advay03/EME-185---Organ-on-a-chip/Components/Low cost peristaltic pump - 254956/images/tube-support.jpg

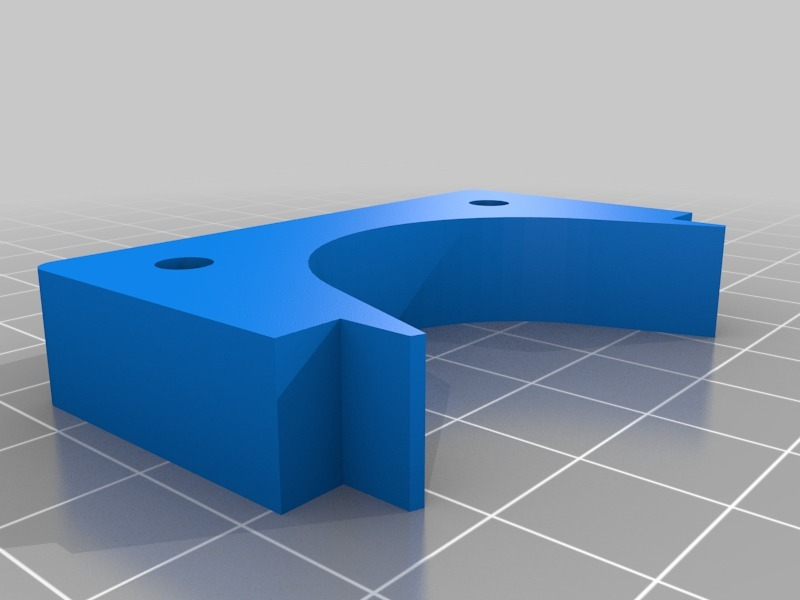
Components/Low cost peristaltic pump - 254956/images/tube-support.jpg
