advay03/EME-185---Organ-on-a-chip/Receipts/Arduino Uno Rev3 Invoice.pdf

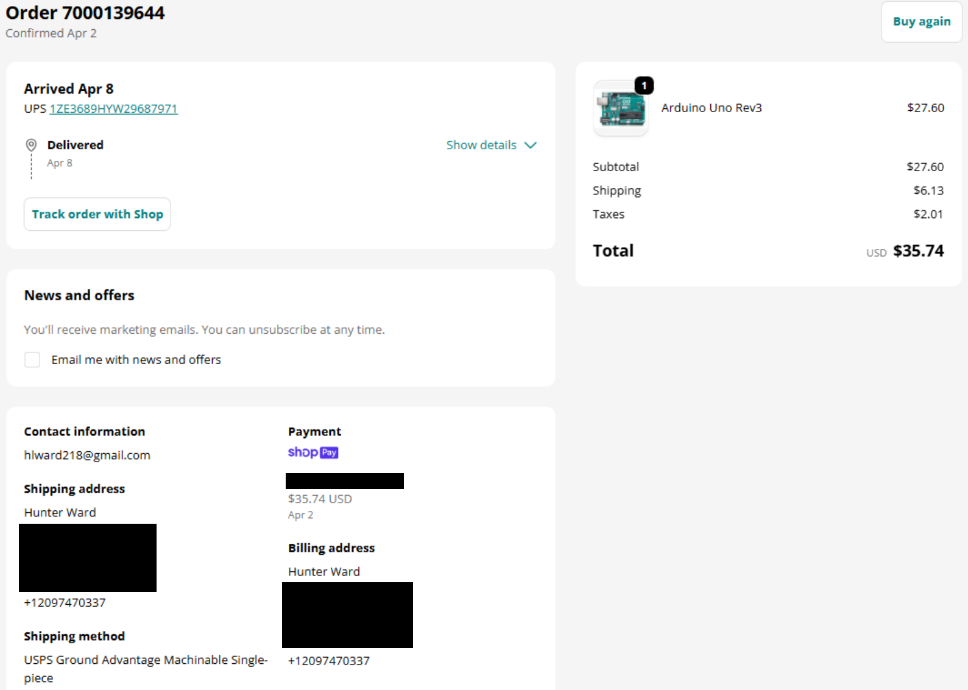
[picture p3: page 1]
