advay03/EME-185---Organ-on-a-chip/Components/Low cost peristaltic pump - 254956/images/bearing-hub-top.jpg

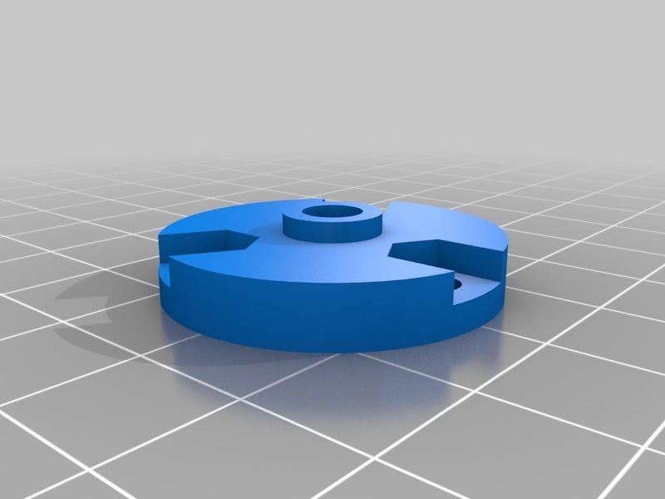
Components/Low cost peristaltic pump - 254956/images/bearing-hub-top.jpg
