advay03/EME-185---Organ-on-a-chip/Components/Low cost peristaltic pump - 254956/images/CheapPump3-1mm-pump-top.png

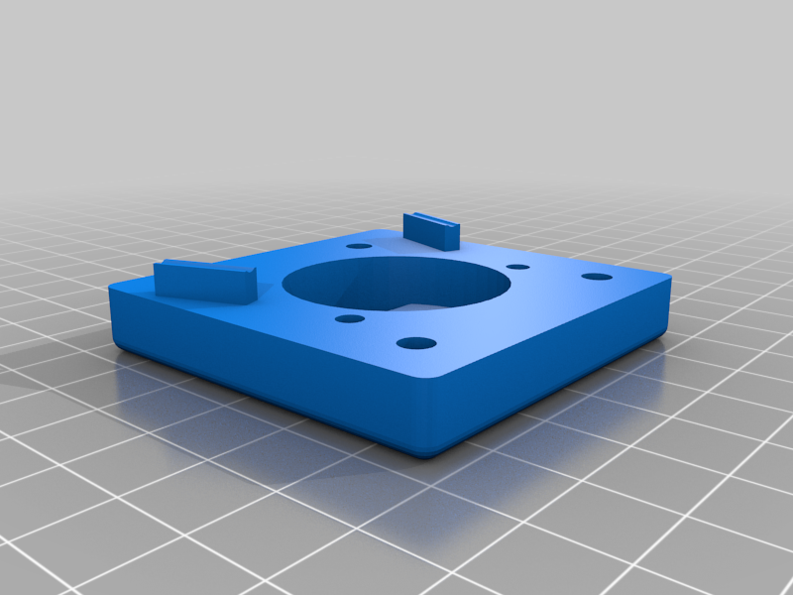
Components/Low cost peristaltic pump - 254956/images/CheapPump3-1mm-pump-top.png
