advay03/EME-185---Organ-on-a-chip/Components/Low cost peristaltic pump - 254956/images/DSCN1205.JPG

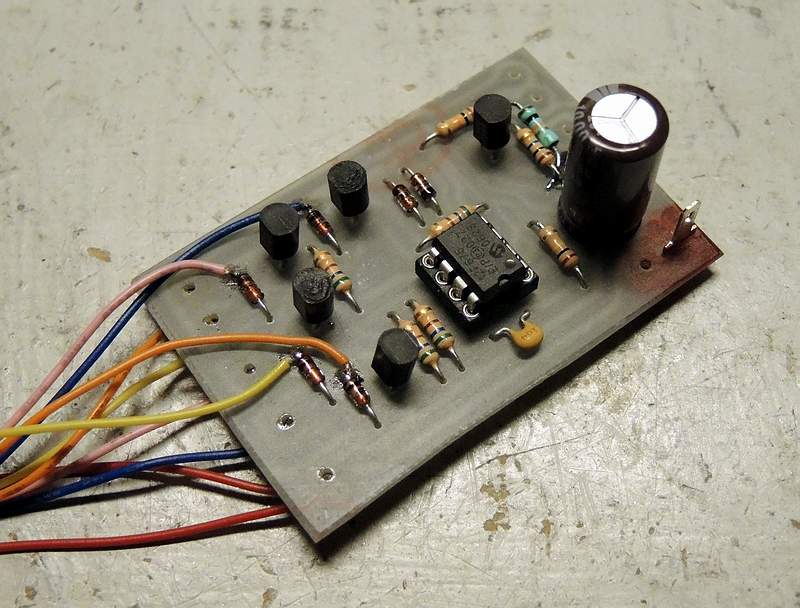
Components/Low cost peristaltic pump - 254956/images/DSCN1205.JPG
