advay03/EME-185---Organ-on-a-chip/Components/Low cost peristaltic pump - 254956/files/PumpaCheapo.SLDASM

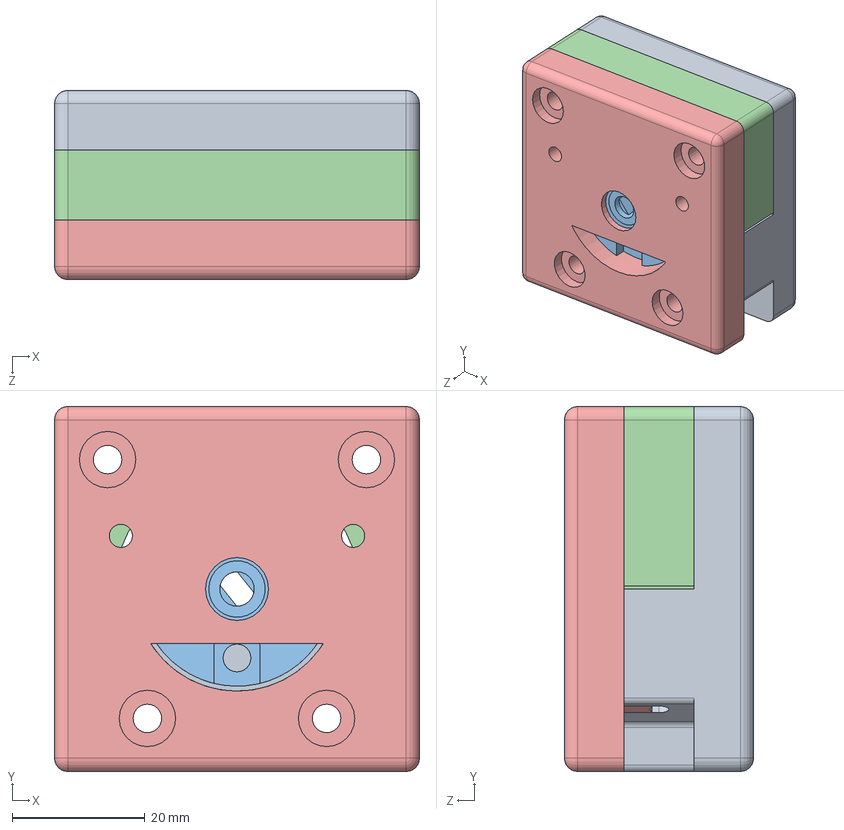
[picture p10: CAD file, 2026-04-03]
Components/Low cost peristaltic pump - 254956/files/PumpaCheapo.SLDASM
55.0 x 55.0 x 28.5 mm
CheapPump
bearing-hub
bearing-hub-top
tube-support
pump-top
