advay03/EME-185---Organ-on-a-chip/Components/Low cost peristaltic pump - 254956/files/CheapPump.SLDPRT

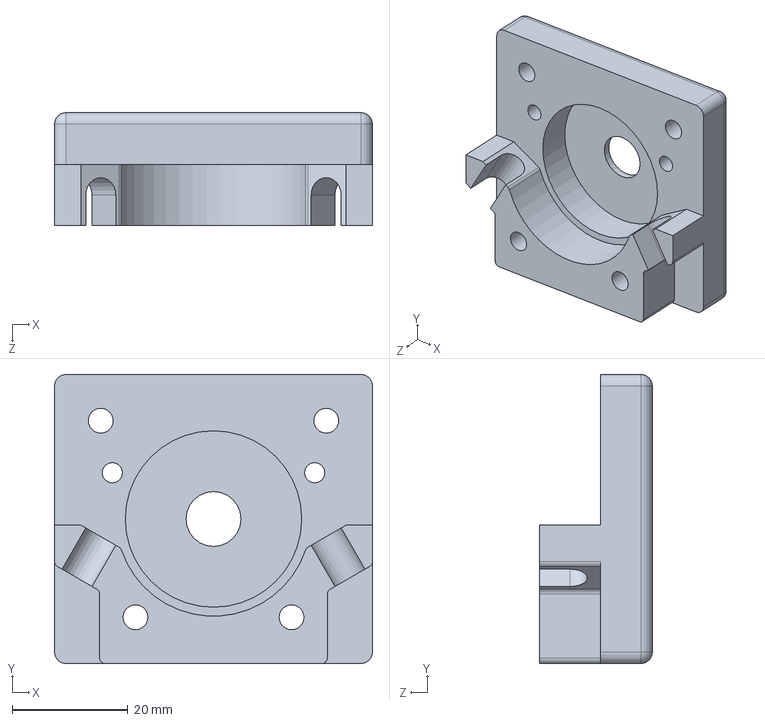
[picture p11: CAD file, 2026-04-03]
Components/Low cost peristaltic pump - 254956/files/CheapPump.SLDPRT
55.0 x 50.0 x 19.5 mm
