advay03/EME-185---Organ-on-a-chip/Electronics/Perf Board.SLDPRT

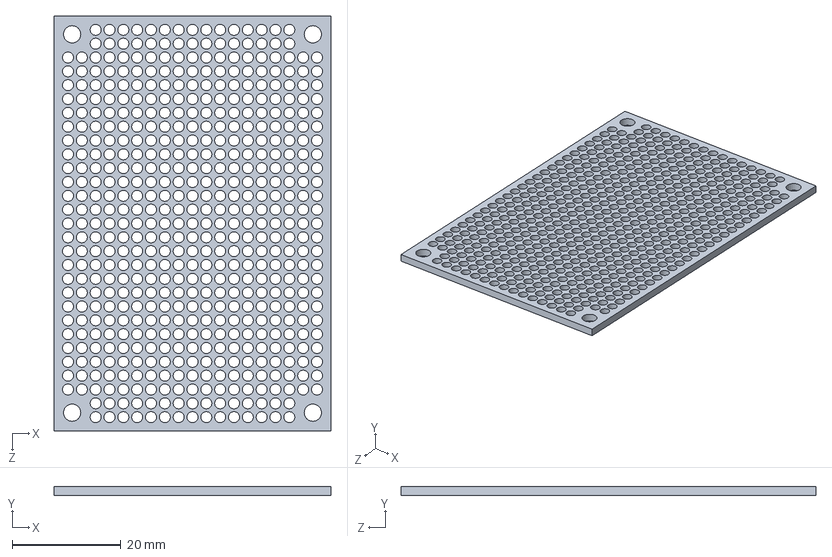
[picture p12: CAD file, 2026-05-25]
Electronics/Perf Board.SLDPRT
50.8 x 1.59 x 76.2 mm
