advay03/EME-185---Organ-on-a-chip/Heater/Heater.SLDPRT

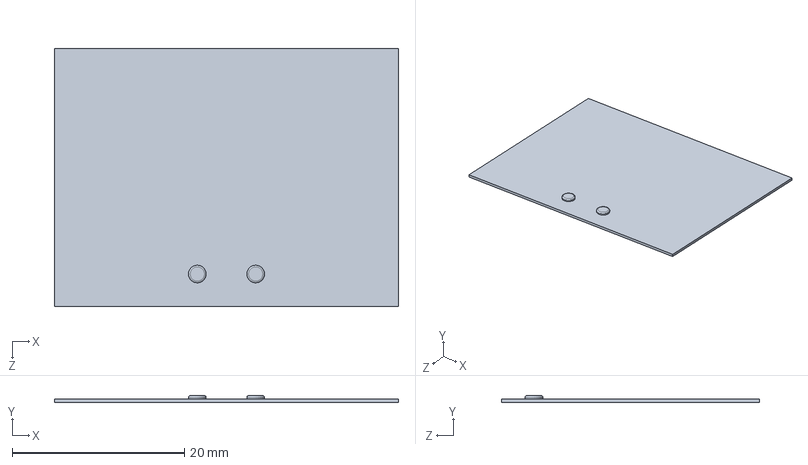
[picture p13: CAD file, 2026-04-03]
Heater/Heater.SLDPRT
40.0 x 0.8 x 30.0 mm
