advay03/EME-185---Organ-on-a-chip/HMI/HMI.stp

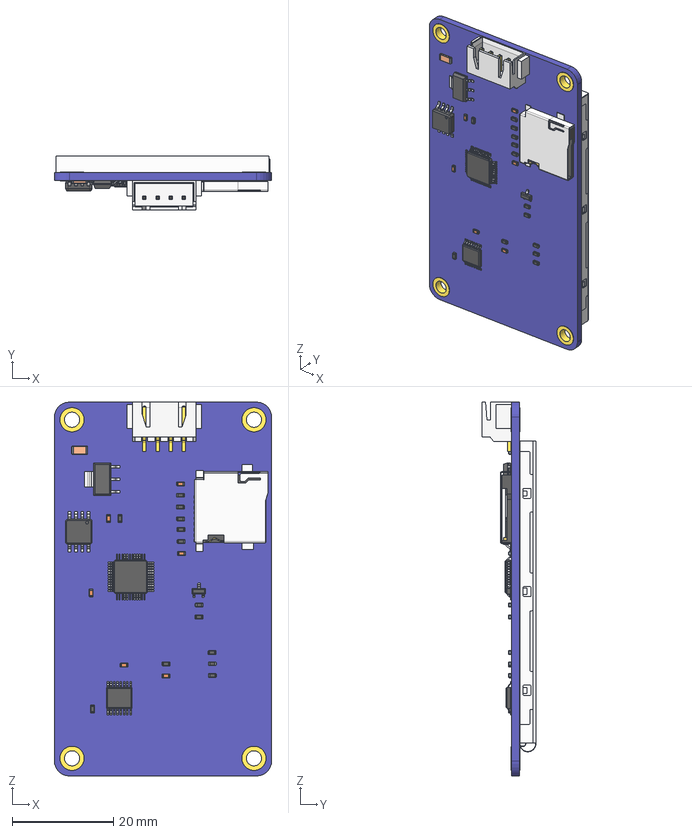
[picture p14: CAD file, 2026-04-03]
HMI/HMI.stp
43.0 x 10.7 x 74.0 mm
NX3224T024_011_PCB
AMS1117
603_Cap x 6
1206_Cap
603_Resistor x 13
IcNextion
24_pin_IC
16_pin_IC
SMD_Trans
Micro_SD_Slot
SD_Center
Nextion_Plug
LCD
