advay03/EME-185---Organ-on-a-chip/Packaging/Rev 3/Tray_Rev3.SLDPRT

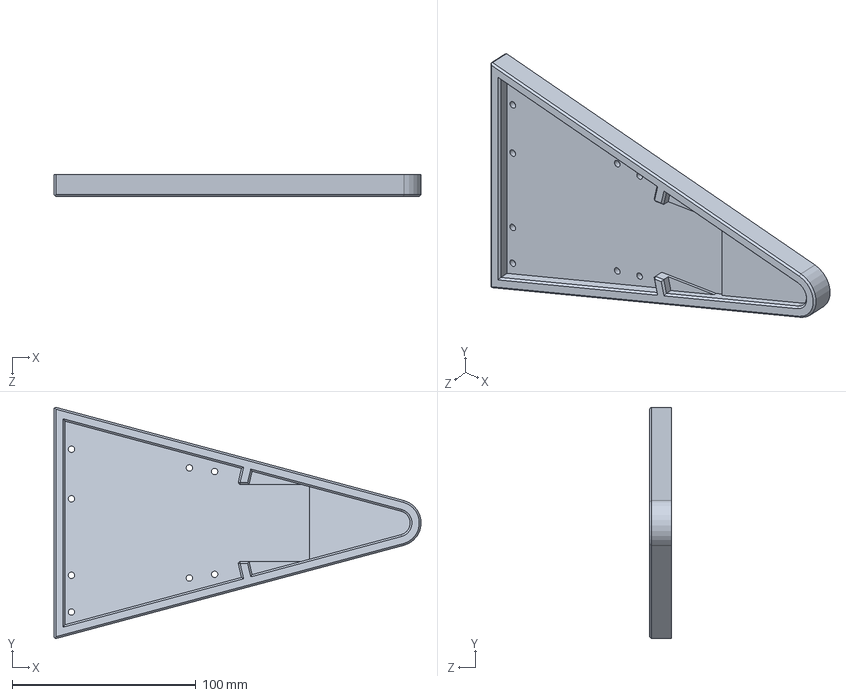
[picture p15: CAD file, 2026-06-06]
Packaging/Rev 3/Tray_Rev3.SLDPRT
199.9 x 126.1 x 12.0 mm
