advay03/EME-185---Organ-on-a-chip/Peristaltic Pump/Custom Design/3D Print Files/Bearing Jig.SLDPRT

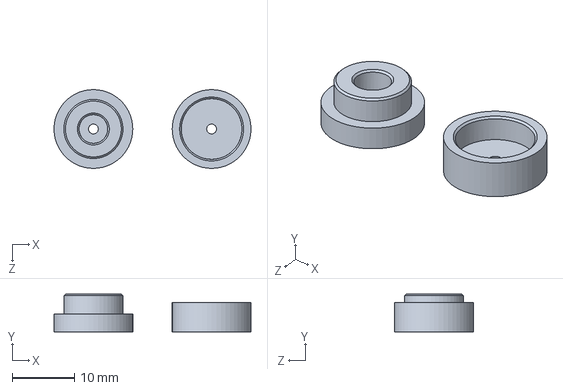
[picture p16: CAD file, 2026-06-06]
Peristaltic Pump/Custom Design/3D Print Files/Bearing Jig.SLDPRT
31.8 x 6.10 x 12.7 mm
