advay03/EME-185---Organ-on-a-chip/Peristaltic Pump/Custom Design/Indivisual Parts/Pump_Rotor_Housing.SLDPRT

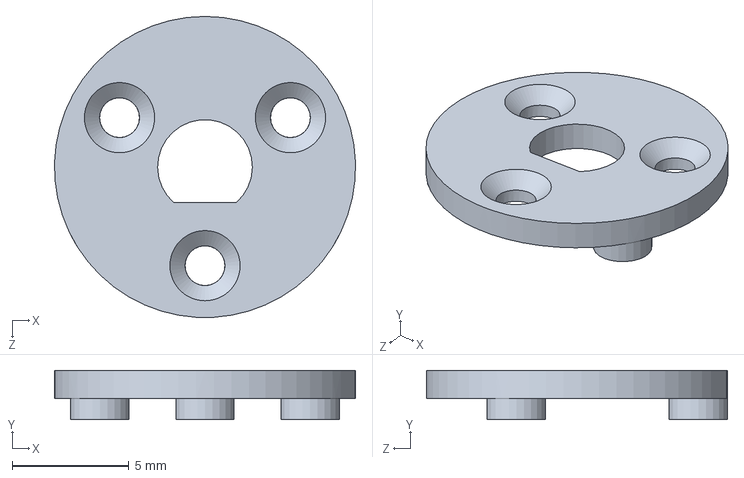
[picture p17: CAD file, 2026-06-06]
Peristaltic Pump/Custom Design/Indivisual Parts/Pump_Rotor_Housing.SLDPRT
12.9 x 2.10 x 12.9 mm
