advay03/EME-185---Organ-on-a-chip/Electronics/6121 TMC2209 Driver.step

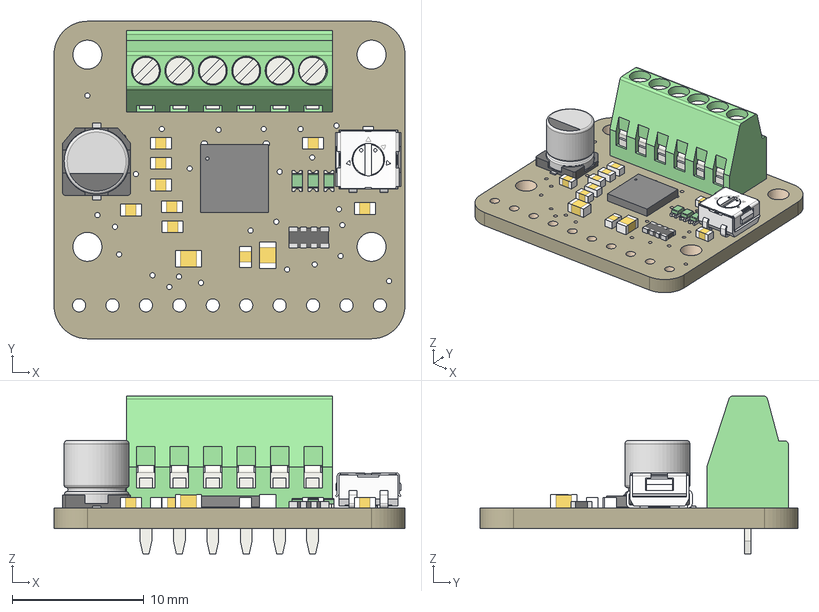
[picture p18: CAD file, 2026-04-03]
Electronics/6121 TMC2209 Driver.step
26.7 x 24.1 x 12.0 mm
Board
0.22uF/50V x 9
10K
10uF x 2
6-pin 2.54 Terminal
22uF/50V
GREEN x 3
20K Pack
TMC2209_QFN
