advay03/EME-185---Organ-on-a-chip/Heater/NTCLE213E3103FLB0A.stp

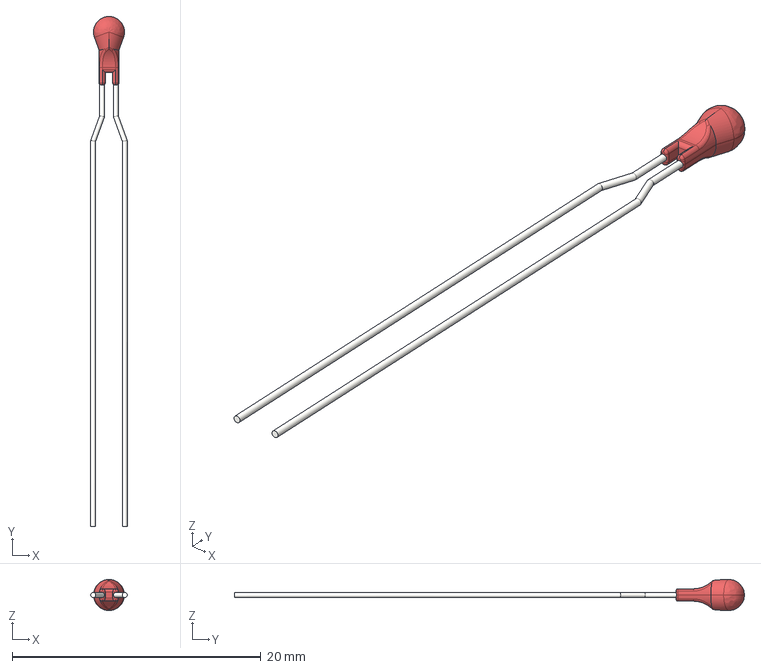
[picture p19: CAD file, 2026-04-03]
Heater/NTCLE213E3103FLB0A.stp
2.94 x 41.0 x 2.50 mm
