advay03/EME-185---Organ-on-a-chip/Packaging/Rev 3/Peristaltic Pump Holder_Rev-3.SLDPRT

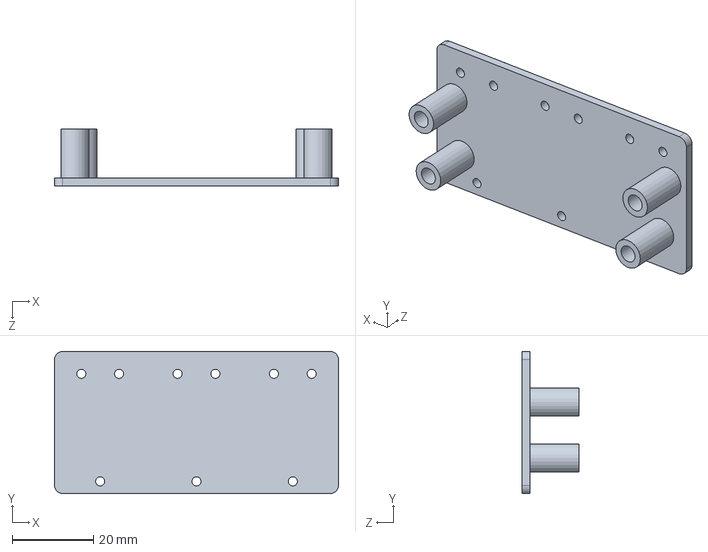
[picture p20: CAD file, 2026-05-25]
Packaging/Rev 3/Peristaltic Pump Holder_Rev-3.SLDPRT
70.0 x 35.0 x 14.0 mm
