advay03/EME-185---Organ-on-a-chip/Peristaltic Pump/Custom Design/3D Print Files/Bearing Jig Lower.SLDPRT

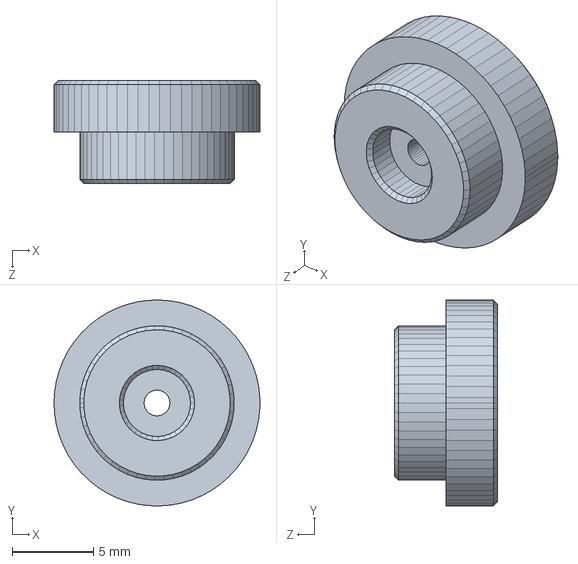
[picture p21: CAD file, 2026-06-06]
Peristaltic Pump/Custom Design/3D Print Files/Bearing Jig Lower.SLDPRT
12.7 x 12.7 x 6.35 mm
