advay03/EME-185---Organ-on-a-chip/Peristaltic Pump/Custom Design/Indivisual Parts/Pump_Housing_Cover.SLDPRT

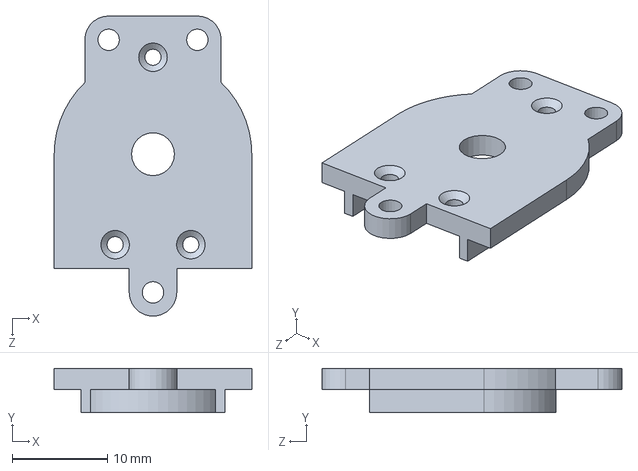
[picture p22: CAD file, 2026-06-06]
Peristaltic Pump/Custom Design/Indivisual Parts/Pump_Housing_Cover.SLDPRT
20.7 x 4.65 x 31.5 mm
