advay03/EME-185---Organ-on-a-chip/Components/Low cost peristaltic pump - 254956/files/CheapPump3-1mm-CheapPump.STL

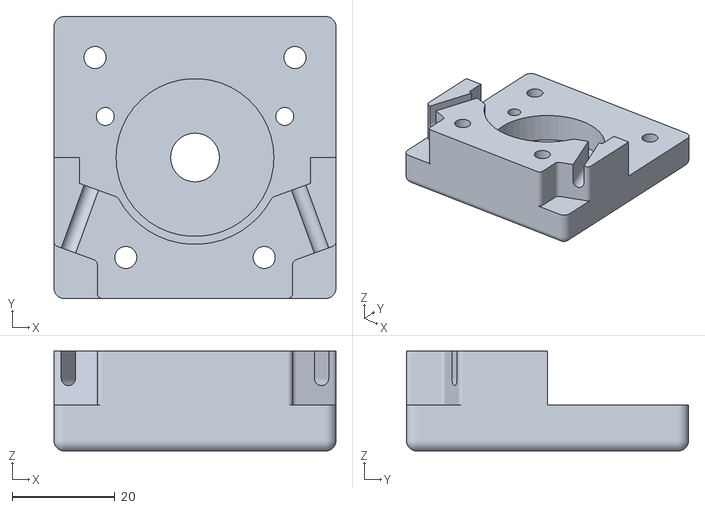
[picture p23: CAD file, 2026-04-03]
Components/Low cost peristaltic pump - 254956/files/CheapPump3-1mm-CheapPump.STL
55.0 x 55.0 x 19.5
