advay03/EME-185---Organ-on-a-chip/Packaging/Rev 3/Perf Board Holder.STL

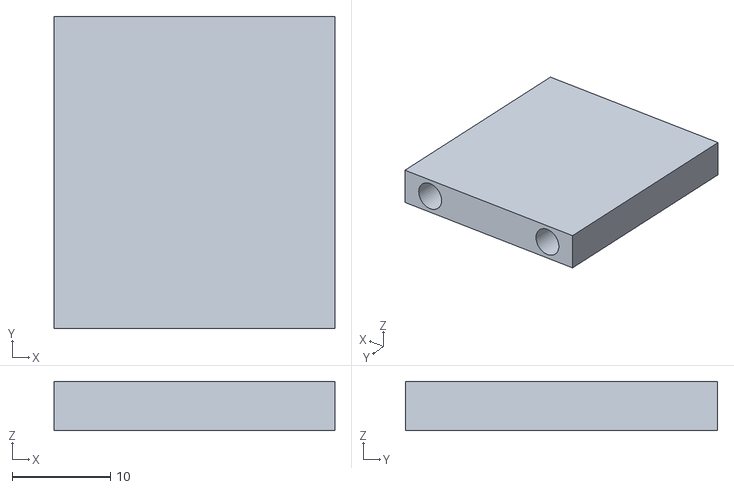
[picture p24: CAD file, 2026-04-20]
Packaging/Rev 3/Perf Board Holder.STL
28.6 x 31.8 x 5.00
