advay03/EME-185---Organ-on-a-chip/Peristaltic Pump/Custom Design/3D Print Files/Bearing Jig Upper.STL

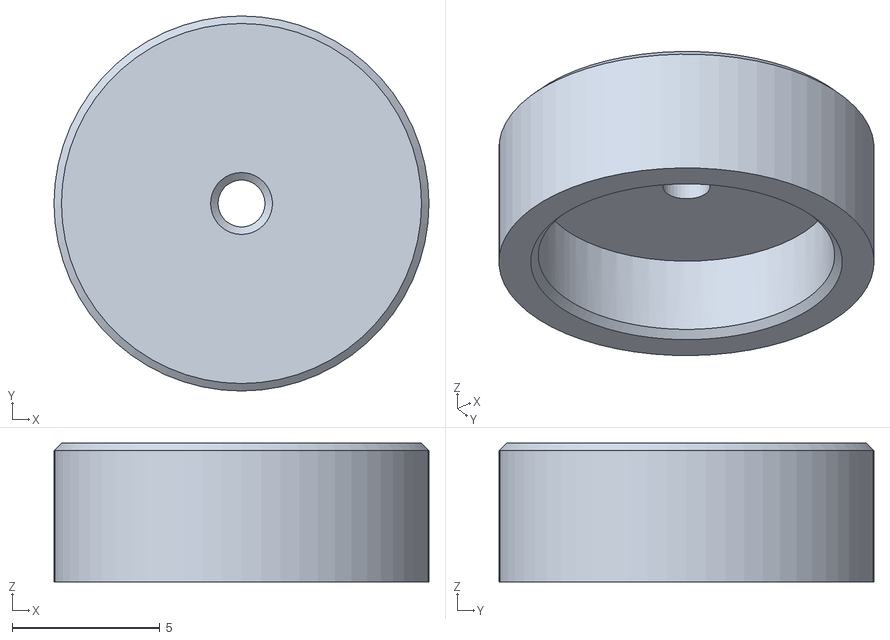
[picture p25: CAD file, 2026-05-29]
Peristaltic Pump/Custom Design/3D Print Files/Bearing Jig Upper.STL
12.7 x 12.7 x 4.70
