advay03/EME-185---Organ-on-a-chip/Peristaltic Pump/Custom Design/Custom_design_v3.SLDPRT

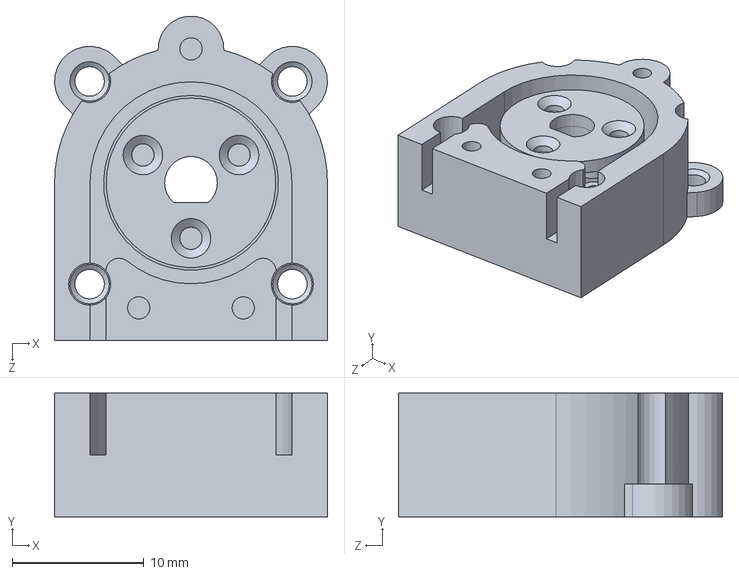
[picture p26: CAD file, 2026-05-12]
Peristaltic Pump/Custom Design/Custom_design_v3.SLDPRT
20.7 x 9.40 x 24.7 mm
