advay03/EME-185---Organ-on-a-chip/Peristaltic Pump/Custom Design/Indivisual Parts/Pump_Housing.SLDPRT

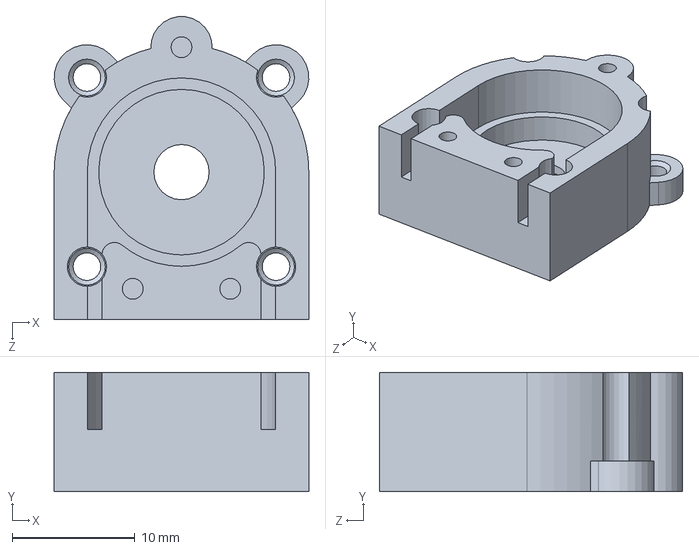
[picture p27: CAD file, 2026-06-06]
Peristaltic Pump/Custom Design/Indivisual Parts/Pump_Housing.SLDPRT
20.7 x 9.70 x 24.7 mm
