advay03/EME-185---Organ-on-a-chip/Peristaltic Pump/PeristalticPump-185.SLDPRT

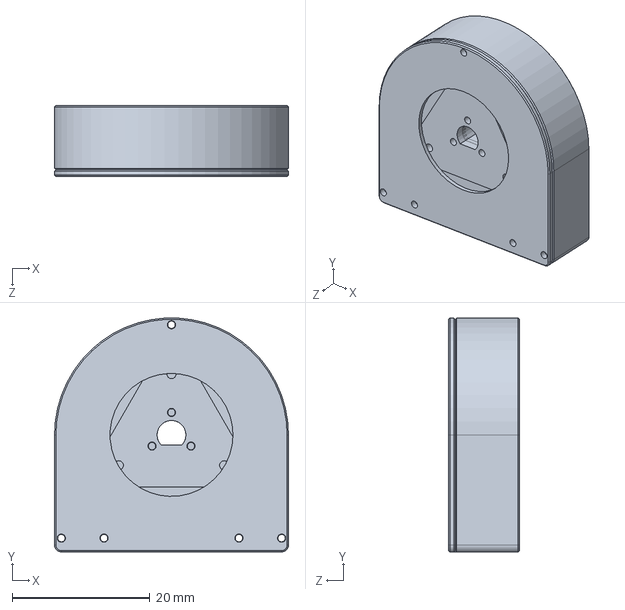
[picture p28: CAD file, 2026-04-03]
Peristaltic Pump/PeristalticPump-185.SLDPRT
34.0 x 34.0 x 10.3 mm
