advay03/EME-185---Organ-on-a-chip/Pod for team 14.stl

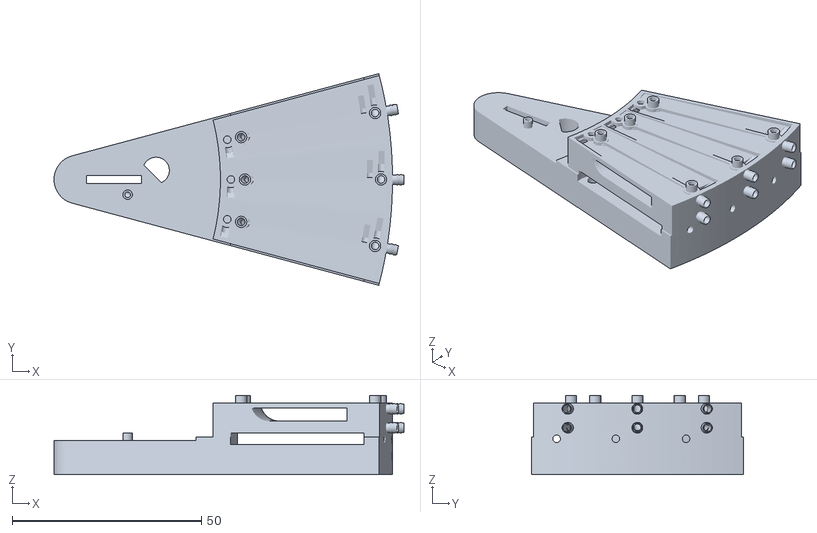
[picture p29: CAD file, 2026-04-03]
Pod for team 14.stl
92.5 x 56.0 x 21.0
