advay03/EME-185---Organ-on-a-chip/Components/Low cost peristaltic pump - 254956/files/pump-top.SLDPRT

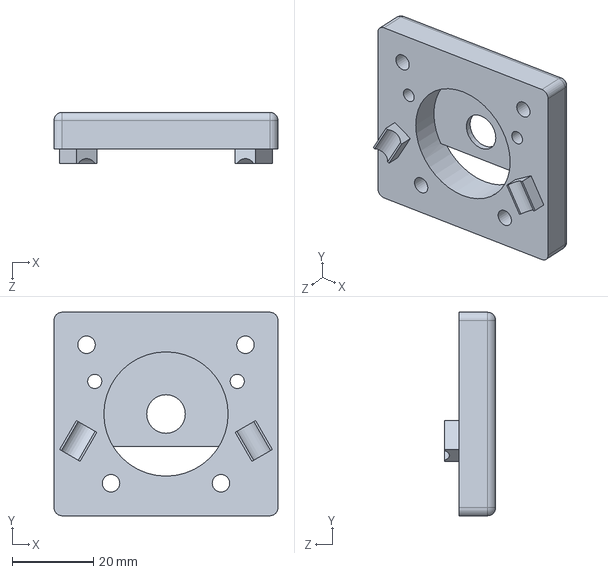
[picture p30: CAD file, 2026-04-03]
Components/Low cost peristaltic pump - 254956/files/pump-top.SLDPRT
55.0 x 50.0 x 12.6 mm
