advay03/EME-185---Organ-on-a-chip/Packaging/Rev 3/Arduino Holder.STL

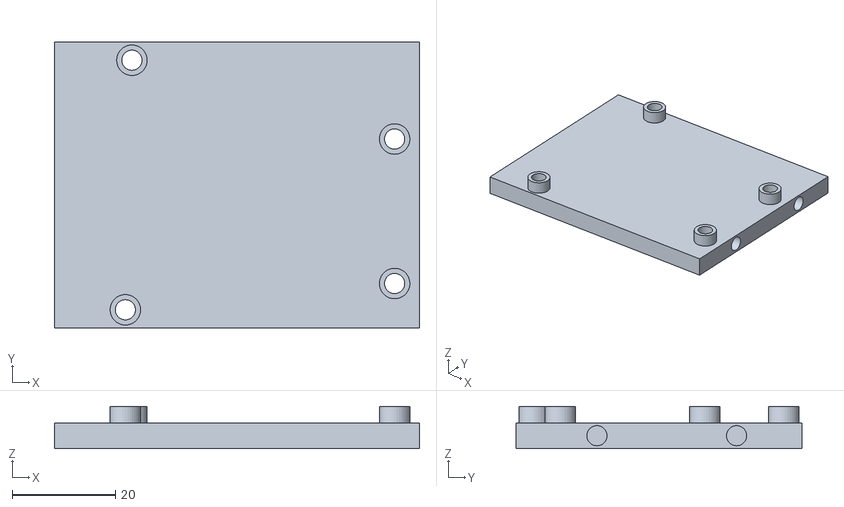
[picture p31: CAD file, 2026-04-20]
Packaging/Rev 3/Arduino Holder.STL
70.6 x 55.3 x 8.18
