advay03/EME-185---Organ-on-a-chip/Peristaltic Pump/Custom Design/3D Print Files/Custom_Rotor.STL

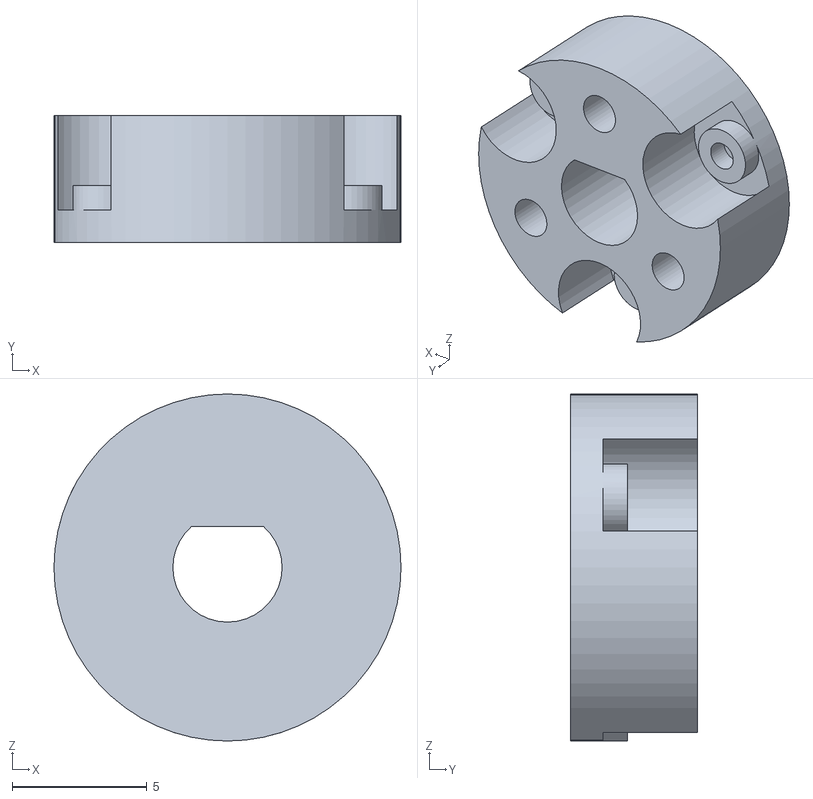
[picture p32: CAD file, 2026-05-25]
Peristaltic Pump/Custom Design/3D Print Files/Custom_Rotor.STL
12.9 x 4.70 x 12.9
