advay03/EME-185---Organ-on-a-chip/Peristaltic Pump/Nema 8 Step motor.STEP

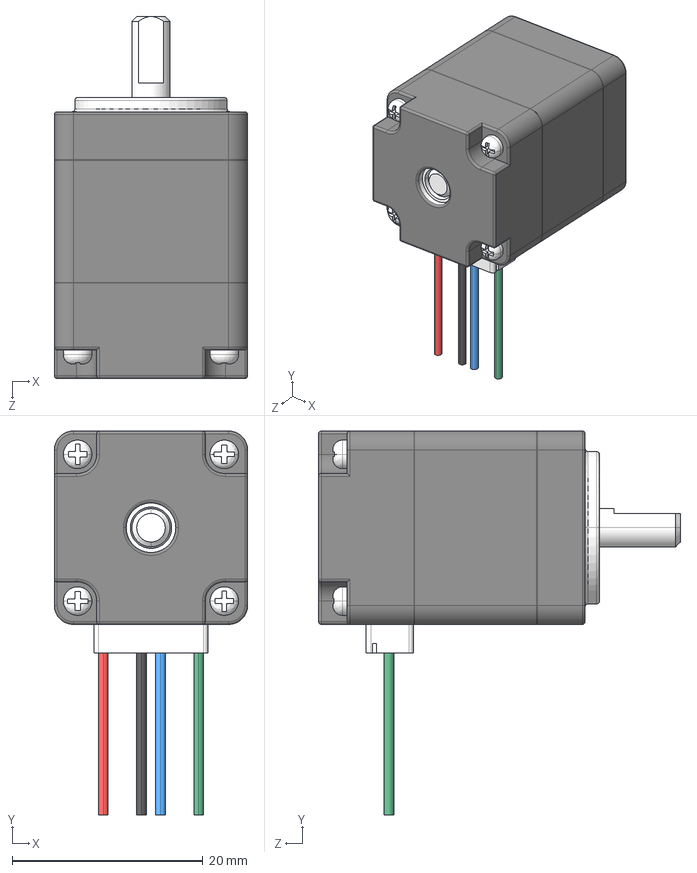
[picture p33: CAD file, 2026-04-03]
Peristaltic Pump/Nema 8 Step motor.STEP
20.3 x 40.3 x 38.0 mm
