advay03/EME-185---Organ-on-a-chip/Components/Low cost peristaltic pump - 254956/files/tube-support.SLDPRT

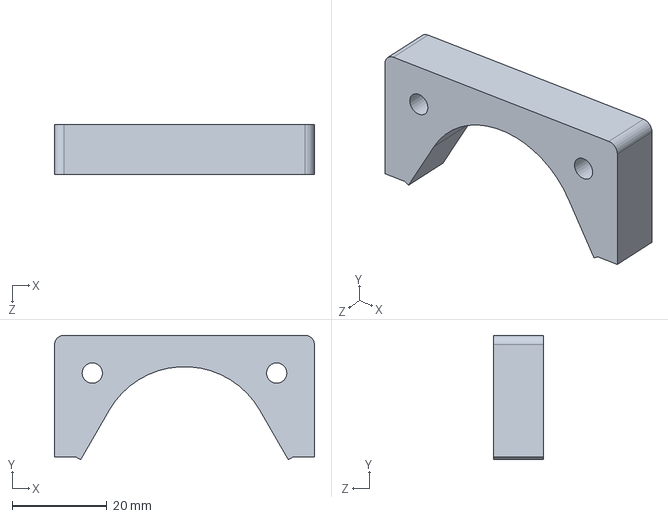
[picture p34: CAD file, 2026-04-03]
Components/Low cost peristaltic pump - 254956/files/tube-support.SLDPRT
55.0 x 26.3 x 10.5 mm
