advay03/EME-185---Organ-on-a-chip/Electronics/Heater control circuit_ Mosfet - FQP30N06.stp

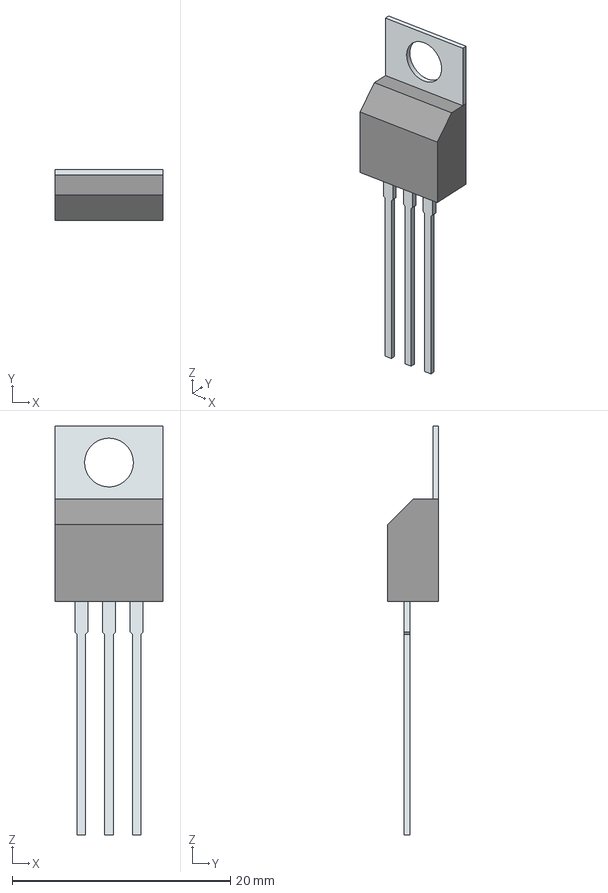
[picture p35: CAD file, 2026-04-03]
Electronics/Heater control circuit_ Mosfet - FQP30N06.stp
9.90 x 4.70 x 37.5 mm
Tab
PinsArray
