advay03/EME-185---Organ-on-a-chip/Components/Low cost peristaltic pump - 254956/files/bearing-hub.SLDPRT

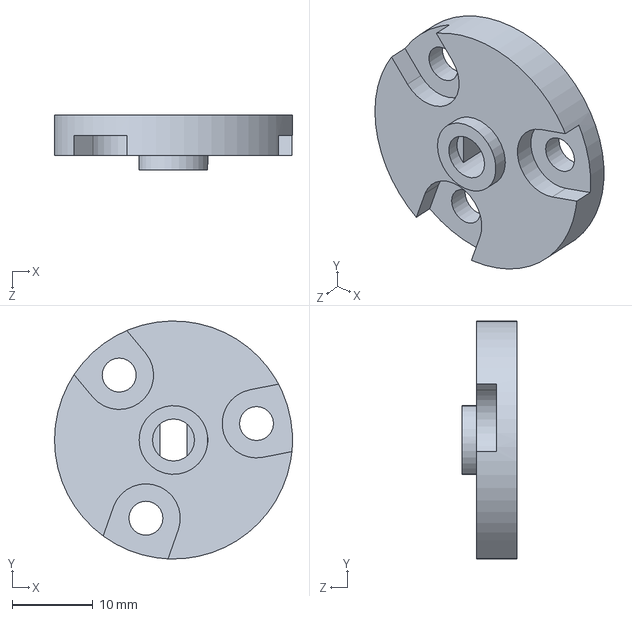
[picture p36: CAD file, 2026-04-03]
Components/Low cost peristaltic pump - 254956/files/bearing-hub.SLDPRT
29.4 x 29.4 x 6.75 mm
