advay03/EME-185---Organ-on-a-chip/Electronics/arduino uno.SLDPRT

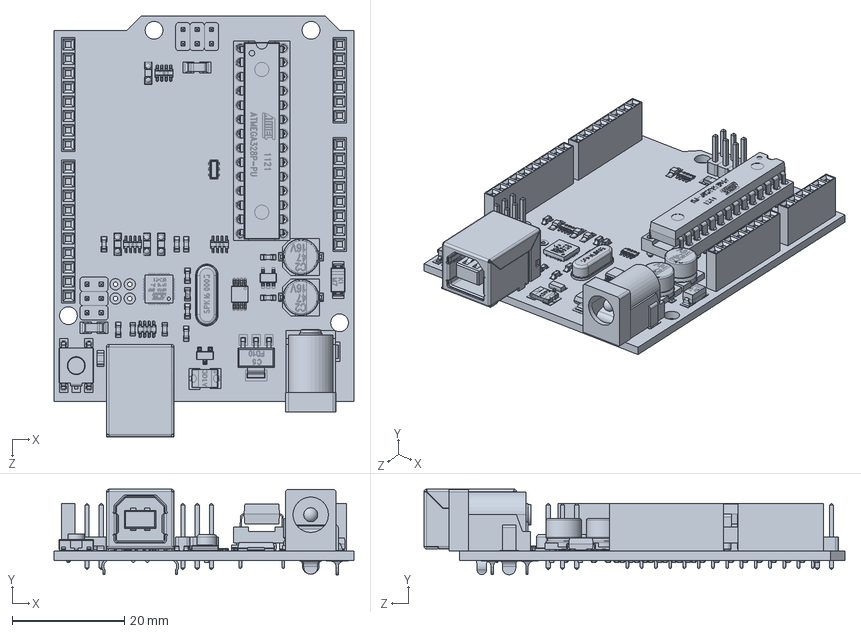
[picture p37: CAD file, 2026-04-03]
Electronics/arduino uno.SLDPRT
53.3 x 15.2 x 74.9 mm
