advay03/EME-185---Organ-on-a-chip/Peristaltic Pump/Custom Design/3D Print Files/Pump_Print_Plate.3mf

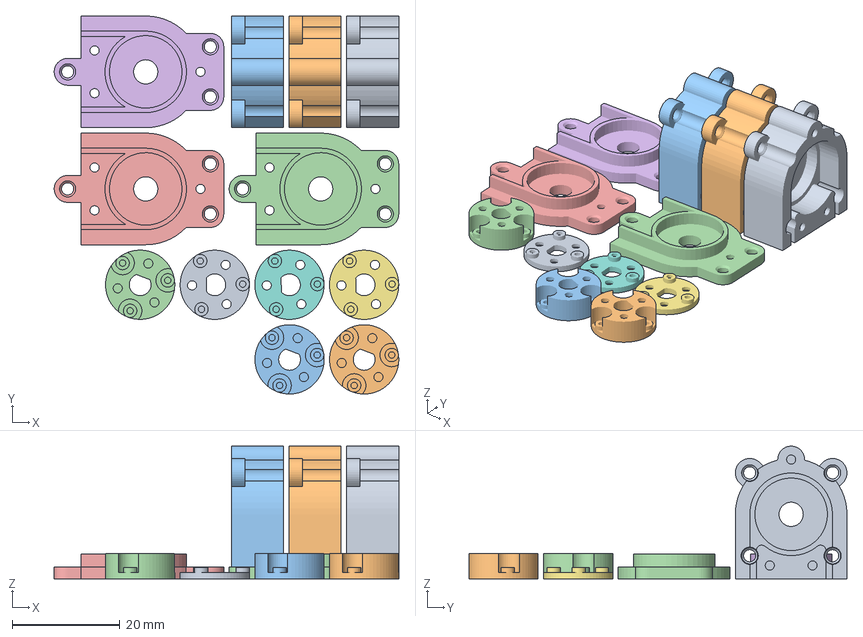
[picture p39: CAD file, 2026-05-25]
Peristaltic Pump/Custom Design/3D Print Files/Pump_Print_Plate.3mf
64.0 x 70.2 x 24.7 mm
Custom_Housing.STL x 3
Custom_Housing_Cap.STL x 3
Custom_Rotor_Cap.STL x 3
Custom_Rotor.STL x 3
