advay03/EME-185---Organ-on-a-chip/Peristaltic Pump/Custom Design/Dowel Pins.SLDPRT

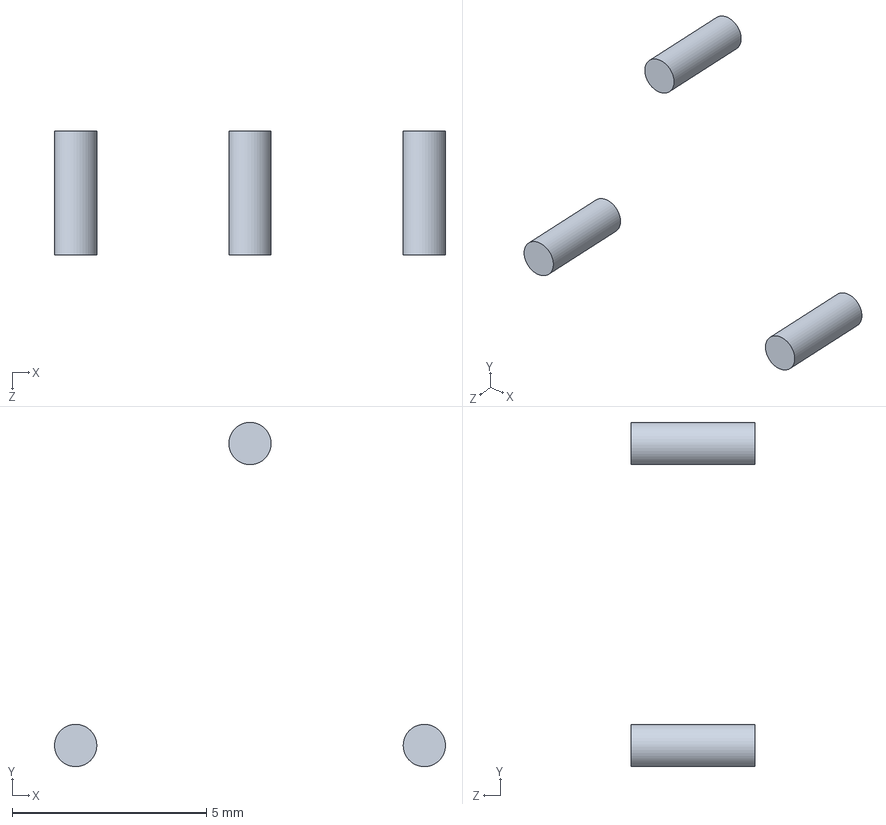
[picture p40: CAD file, 2026-04-14]
Peristaltic Pump/Custom Design/Dowel Pins.SLDPRT
10.1 x 8.87 x 3.20 mm
