advay03/EME-185---Organ-on-a-chip/Components/Low cost peristaltic pump - 254956/files/CheapPump3-1mm-pump-top.STL

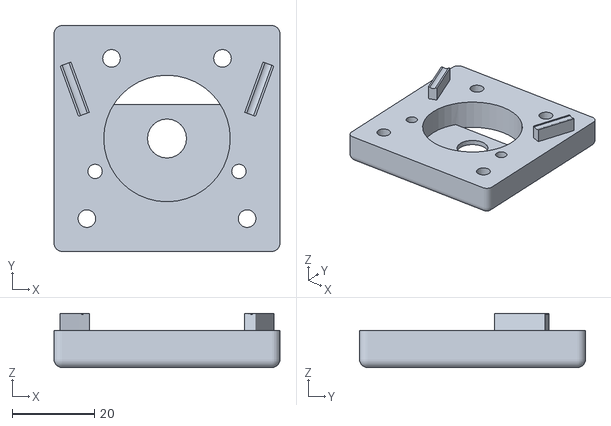
[picture p41: CAD file, 2026-04-03]
Components/Low cost peristaltic pump - 254956/files/CheapPump3-1mm-pump-top.STL
55.0 x 55.0 x 13.2
