advay03/EME-185---Organ-on-a-chip/Peristaltic Pump/Custom Design/Custom design.SLDPRT

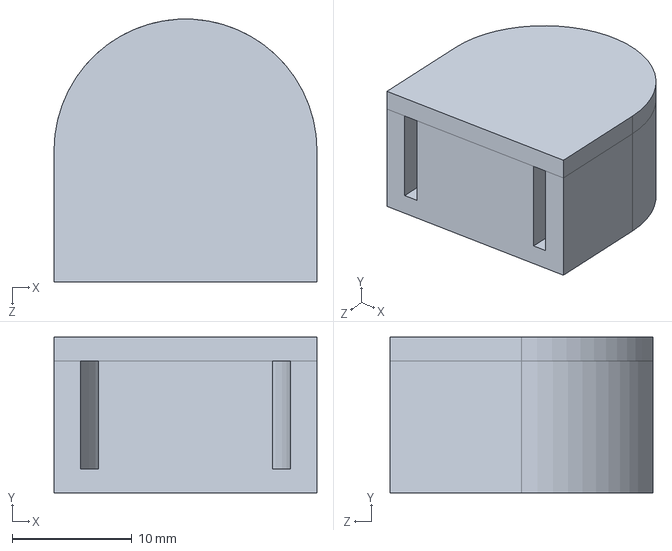
[picture p42: CAD file, 2026-04-08]
Peristaltic Pump/Custom Design/Custom design.SLDPRT
21.9 x 13.0 x 21.9 mm
