advay03/EME-185---Organ-on-a-chip/Components/Low cost peristaltic pump - 254956/files/pump-base.stl

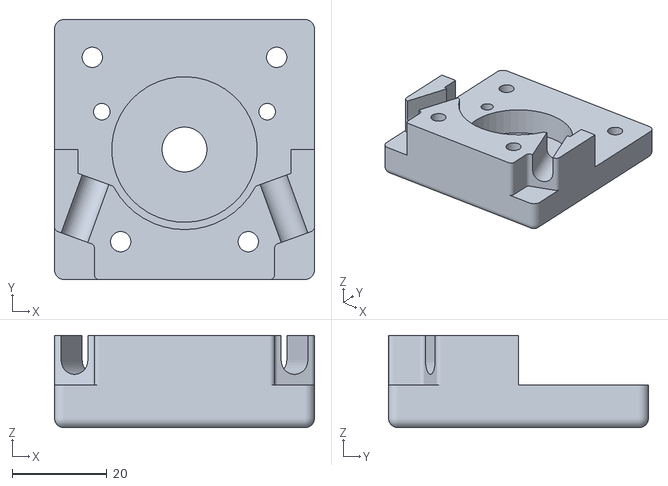
[picture p43: CAD file, 2026-04-03]
Components/Low cost peristaltic pump - 254956/files/pump-base.stl
55.0 x 55.0 x 19.5
