advay03/EME-185---Organ-on-a-chip/Peristaltic Pump/Pump Subassembly.SLDASM

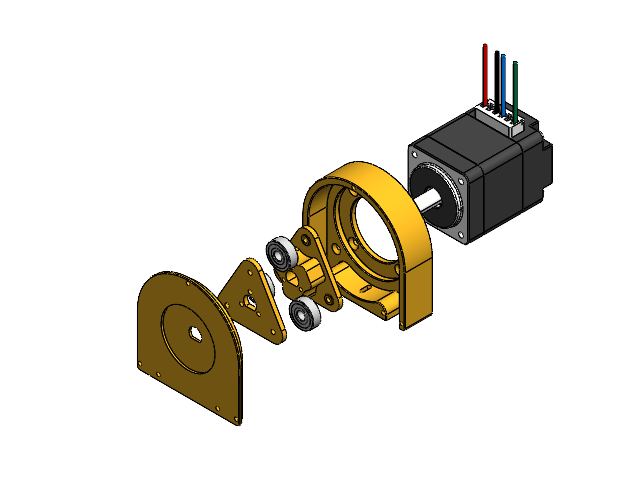
[picture p44: CAD file, 2026-04-04]
Peristaltic Pump/Pump Subassembly.SLDASM
PeristalticPump-185
Nema 8 Step motor.step
7487N44_High-Precision Corrosion-Resistant 440C Stainless Steel Ball Bearing x 3
