advay03/EME-185---Organ-on-a-chip/System Assembly - Rev 3.SLDASM

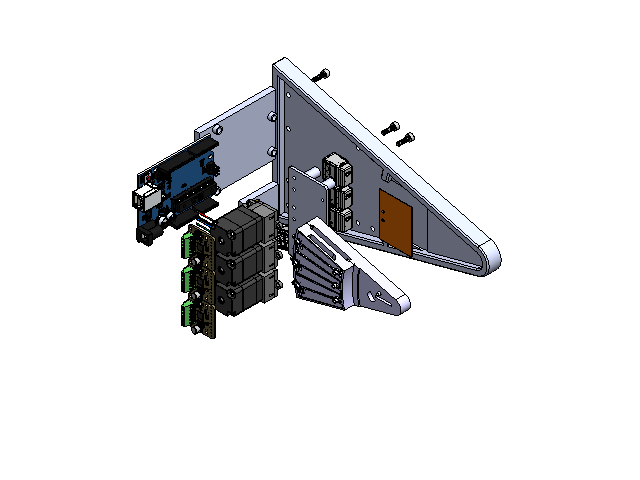
[picture p45: CAD file, 2026-06-06]
System Assembly - Rev 3.SLDASM
Tray_Rev3
Pod for team 14
Arduino Holder
Perf Board Holder
Peristaltic Pump Holder_Rev-3
Custom_design_v2 x 3
57155K341_Stainless Steel Ball Bearing x 9
Dowel Pins x 3
91305A103_JIS Zinc-Plated Steel Flat Head Screws x 30
Nema 8 Step motor.step x 3
arduino uno
Perf Board
9915K36_Quick-Connect Push-on Wire Connectors x 3
9915K37_Quick-Connect Push-on Wire Connectors
Board_2.step x 3
0.22uF_50V_2.step x 27
10K_2.step x 3
10uF_2.step x 6
6-pin 2.54 Terminal_2.step x 3
22uF_50V_2.step x 3
GREEN_2.step x 9
20K Pack_2.step x 3
TMC2209_QFN_2.step x 3
91292A113_18-8 Stainless Steel Socket Head Screw x 8
Heater
