advay03/EME-185---Organ-on-a-chip/Peristaltic Pump/Custom Design/Custom Pump Assembly.SLDASM

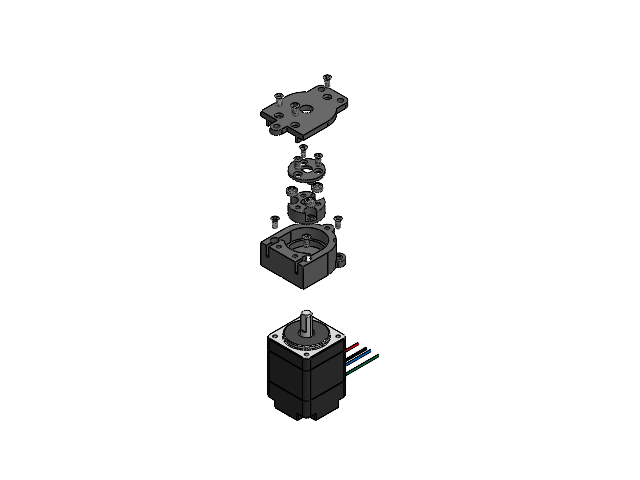
[picture p46: CAD file, 2026-06-06]
Peristaltic Pump/Custom Design/Custom Pump Assembly.SLDASM
Custom_design_v2
57155K341_Stainless Steel Ball Bearing x 3
Dowel Pins
91305A103_JIS Zinc-Plated Steel Flat Head Screws x 10
Nema 8 Step motor.step
