advay03/EME-185---Organ-on-a-chip/(list of files, cad)

Other CAD files:
Peristaltic Pump/Custom Design/Indivisual Parts/Pump_Rotor.SLDPRT
Peristaltic Pump/Custom Design/3D Print Files/Custom_Rotor_Cap.STL
Peristaltic Pump/Custom Design/3D Print Files/Custom_Housing.STL
Peristaltic Pump/Custom Design/3D Print Files/Custom_Housing_Cap.STL
Components/Low cost peristaltic pump - 254956/files/bearing-hub-top.stl
Components/Low cost peristaltic pump - 254956/files/bearing-hub.stl
Components/Low cost peristaltic pump - 254956/files/pump-top.stl
Components/Low cost peristaltic pump - 254956/files/tube-support.stl
Drawings/Rev 2/Circuit Assembly Lid.SLDDRW
Drawings/Rev 2/Electronics System.SLDDRW
Drawings/Rev 2/HMI.SLDDRW
Drawings/Rev 2/Packaging Assembly.SLDDRW
Drawings/Rev 2/PeristalticPump Cover.SLDDRW
Drawings/Rev 2/PeristalticPump Housing.SLDDRW
Drawings/Rev 2/PeristalticPump Rotor Cover.SLDDRW
Drawings/Rev 2/PeristalticPump Rotor.SLDDRW
Drawings/Rev 2/PeristalticPump-185.SLDDRW
Drawings/Rev 2/Pod Base.SLDDRW
Drawings/Rev 2/Pod for team 14.SLDDRW
Drawings/Rev 2/Pump Assembly Lid.SLDDRW
Drawings/Rev 2/Pump Subassembly.SLDDRW
Drawings/Rev 2/TRAY ASSEMBLY.SLDDRW
Drawings/Rev 2/Thermal System.SLDDRW
Drawings/Rev 3/Arduino Holder.SLDDRW
Drawings/Rev 3/Custom Pump Assembly.SLDDRW
Drawings/Rev 3/Custom Pump Assembly_Exploded Viiew.SLDDRW
Drawings/Rev 3/Perf Board Holder.SLDDRW
Drawings/Rev 3/Peristaltic Pump Holder_Rev-3.SLDDRW
Drawings/Rev 3/Pump_Housing.SLDDRW
Drawings/Rev 3/Pump_Housing_Cover.SLDDRW
Drawings/Rev 3/Pump_Rotor.SLDDRW
Drawings/Rev 3/Pump_Rotor_Housing.SLDDRW
Drawings/Rev 3/System Assembly - Exploded View.SLDDRW
Drawings/Rev 3/System Assembly - Rev 3.SLDDRW
Drawings/Rev 3/Tray_Rev3.SLDDRW
Electronics/6121 TMC2209 Driver.SLDASM
Electronics/8320N61_Barrel-Style DC Connector.SLDPRT
Electronics/9915K36_Quick-Connect Push-on Wire Connectors.SLDPRT
Electronics/9915K37_Quick-Connect Push-on Wire Connectors.SLDPRT
HMI/HMI.SLDASM
Hardware/91292A113_18-8 Stainless Steel Socket Head Screw.SLDPRT
Packaging/Drawings/Tray Dimensions Drawing.SLDDRW
Packaging/Rev 1/Circuit Assembly Lid.SLDPRT
Packaging/Rev 1/Hose Clamp.SLDPRT
Packaging/Rev 1/Packaging Assembly.SLDASM
Packaging/Rev 1/Pod Base.SLDPRT
Packaging/Rev 1/Pod for team 14.SLDPRT
Packaging/Rev 1/Power Adaptor CAD.SLDPRT
Packaging/Rev 1/Pump Assembly Lid.SLDPRT
Packaging/Rev 1/TRAY ASSEMBLY.SLDASM
Packaging/Rev 1/Tray Assembly - Pod, Pump, & Tray.SLDASM
Packaging/Rev 1/Velcro.SLDPRT
Packaging/Rev 2/Arduino Holder.SLDPRT
Packaging/Rev 2/MC Board Base.SLDPRT
Packaging/Rev 2/MC Board Spacer.SLDPRT
Packaging/Rev 2/Part1.SLDPRT
Packaging/Rev 2/Perf Board Holder.SLDPRT
Packaging/Rev 2/Pod Base_Rev2.SLDPRT
Packaging/Rev 2/Pump Riser.SLDPRT
Packaging/Rev 2/Tray Base_Rev2.SLDPRT
Packaging/Rev 3/Peristaltic Pump Holder_Rev-3.STL
Packaging/Rev 3/Tray_Rev3.STL
Peristaltic Pump/7487N44_High-Precision Corrosion-Resistant 440C Stainless Steel Ball Bearing.SLDPRT
Peristaltic Pump/Custom Design/3D Print Files/Bearing Jig Lower.STL
Peristaltic Pump/Custom Design/3D Print Files/Bearing Jig.SLDDRW
Peristaltic Pump/Custom Design/57155K341_Stainless Steel Ball Bearing.SLDPRT
Peristaltic Pump/Custom Design/91305A103_JIS Zinc-Plated Steel Flat Head Screws.SLDPRT
Peristaltic Pump/Custom Design/91430A150_18-8 Stainless Steel Slotted Flat Head Screw.SLDPRT
Peristaltic Pump/Custom Design/Custom_design_v2.SLDPRT
Pod for team 14.CATPart
System Assembly.SLDASM
