advay03/EME-185---Organ-on-a-chip/Drawings/Rev 3/Custom Pump Assembly_Exploded View.PDF

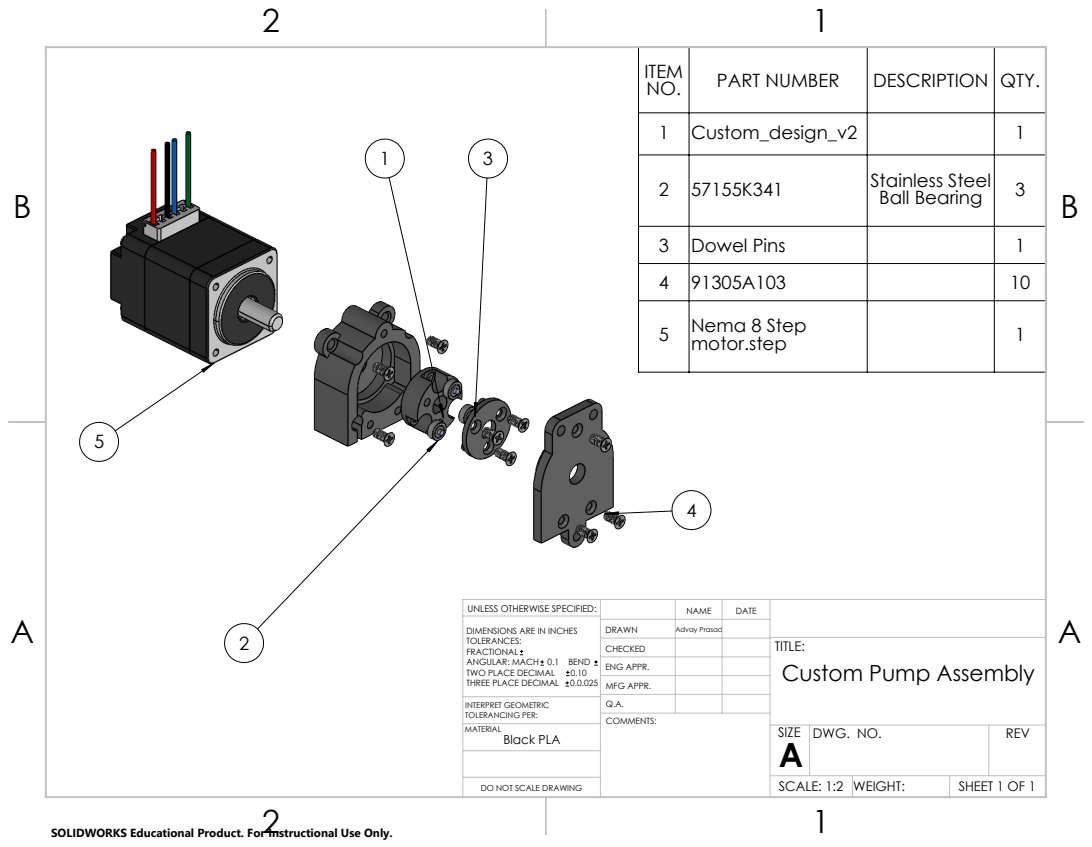
[picture p48: page 1]
Black PLA; SHEET 1 OF 1; SCALE: 1:2; WEIGHT:; DWG. NO.; REV

ITEM NO. | PART NUMBER | DESCRIPTION | QTY.

1 | Custom_design_v2 | | 1

2 | 57155K341 | Stainless Steel Ball Bearing | 3

3 | Dowel Pins | | 1
4 | 91305A103 | | 10
5 | Nema 8 Step motor.step | | 1

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

CHECKED | | | TITLE: Custom Pump Assembly

ENG APPR.
MFG APPR.

INTERPRET GEOMETRIC TOLERANCING PER: | Q.A.

DO NOT SCALE DRAWING

SOLIDWORKS Educational Product. For Instructional Use Only.
