advay03/EME-185---Organ-on-a-chip/Drawings/Rev 3/System Assembly - Exploded View.pdf

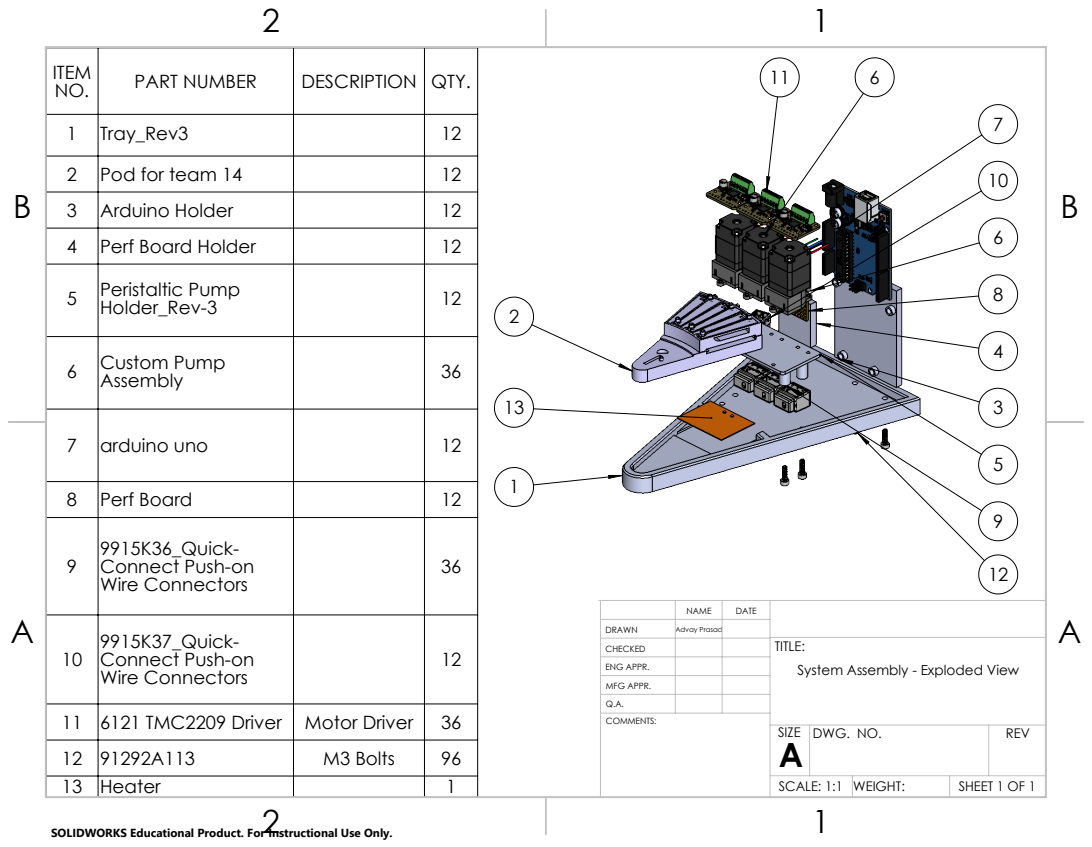
[picture p49: page 1]
SCALE: 1:1; WEIGHT:; SHEET 1 OF 1

ITEM NO. | PART NUMBER | DESCRIPTION | QTY.

1 | Tray_Rev3 | | 12
2 | Pod for team 14 | | 12
3 | Arduino Holder | | 12
4 | Perf Board Holder | | 12
5 | Peristaltic Pump Holder_Rev-3 | | 12

6 | Custom Pump Assembly | | 36

7 | arduino uno | | 12

8 | Perf Board | | 12

9 | 9915K36_Quick-Connect Push-on Wire Connectors | | 36

NAME | DATE

DRAWN | Advay Prasad
CHECKED | | | TITLE: System Assembly - Exploded View

10 | 9915K37_Quick-Connect Push-on Wire Connectors | | 12

ENG APPR.
MFG APPR.
Q.A.

11 | 6121 TMC2209 Driver | Motor Driver | 36
12 | 91292A113 | M3 Bolts | 96

SIZE A | DWG. NO. | REV

SOLIDWORKS Educational Product. For Instructional Use Only.
