advay03/EME-185---Organ-on-a-chip/Receipts/Invoice Perfboard + MOSFET + Power Supply + Thermistors + 26awg Wire - Amazon.pdf

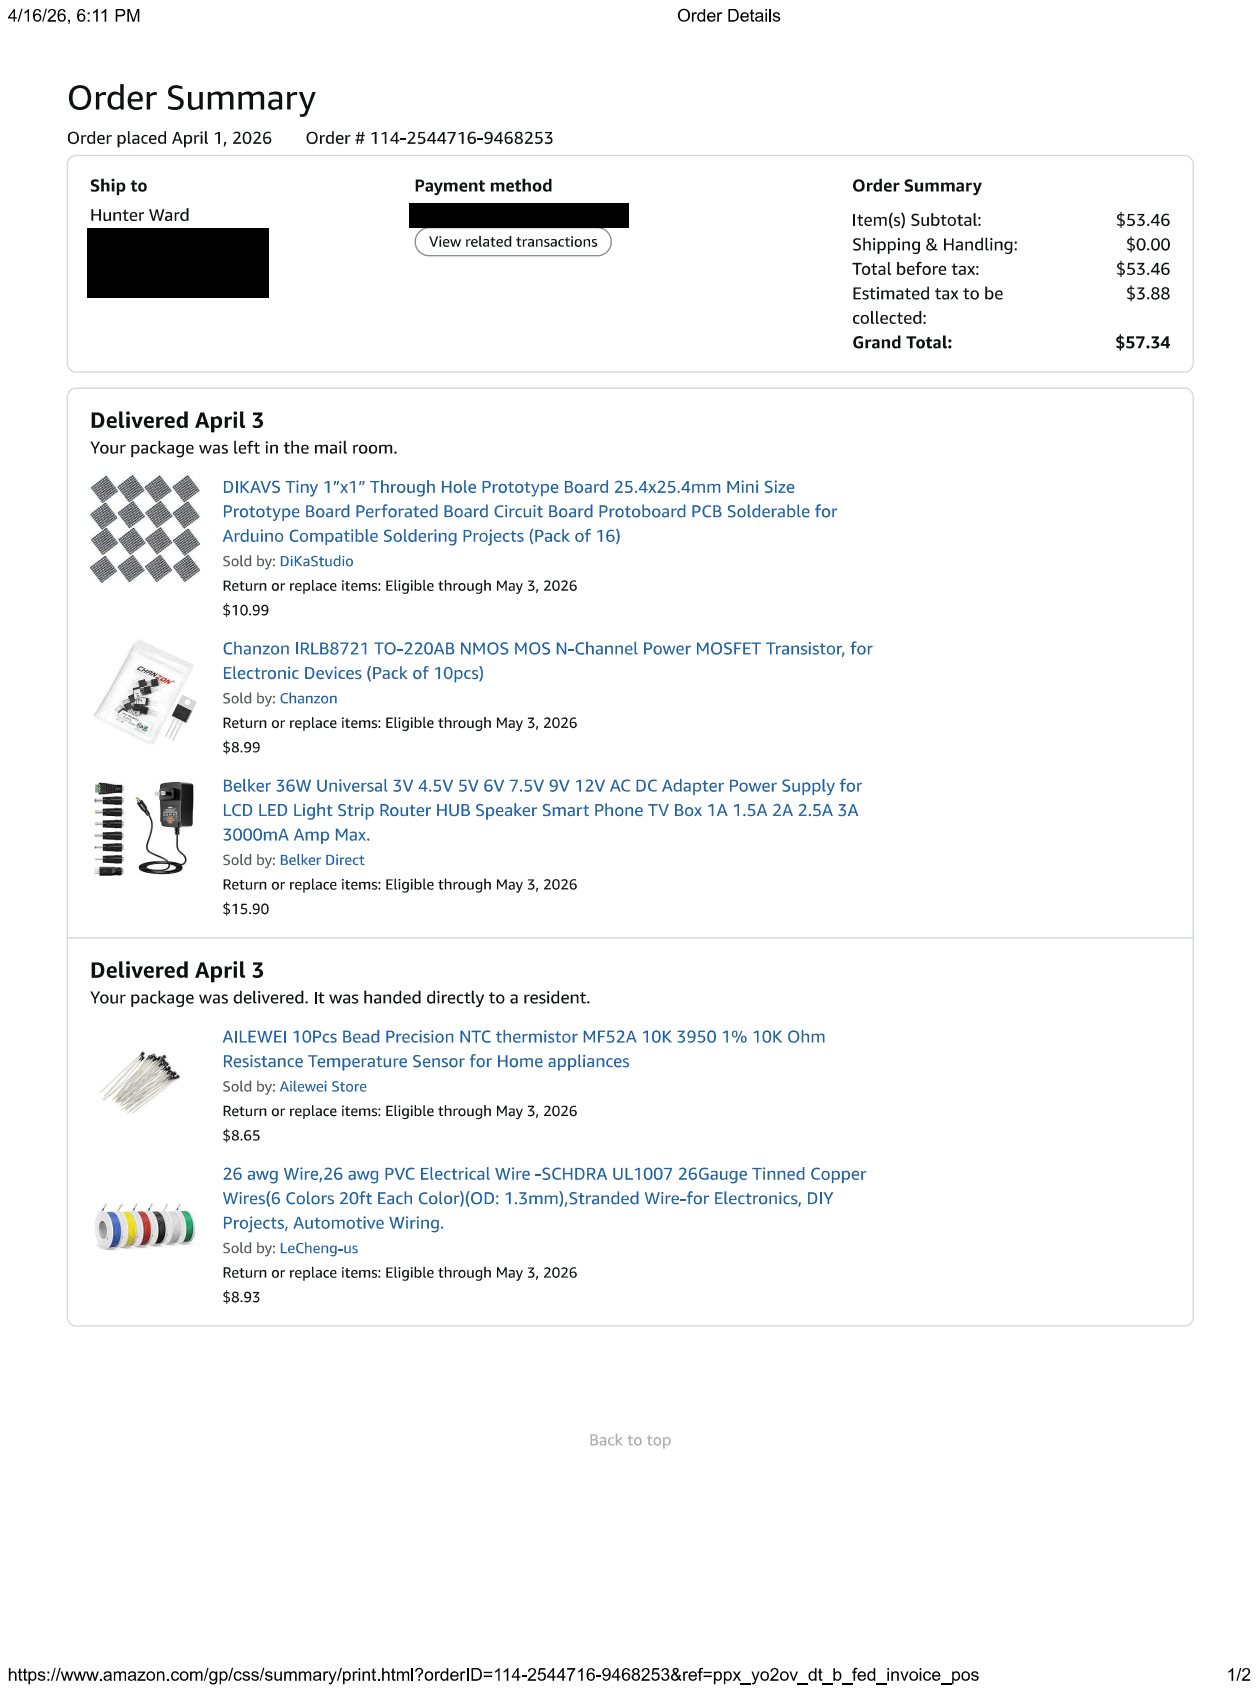
[picture p50: page 1]

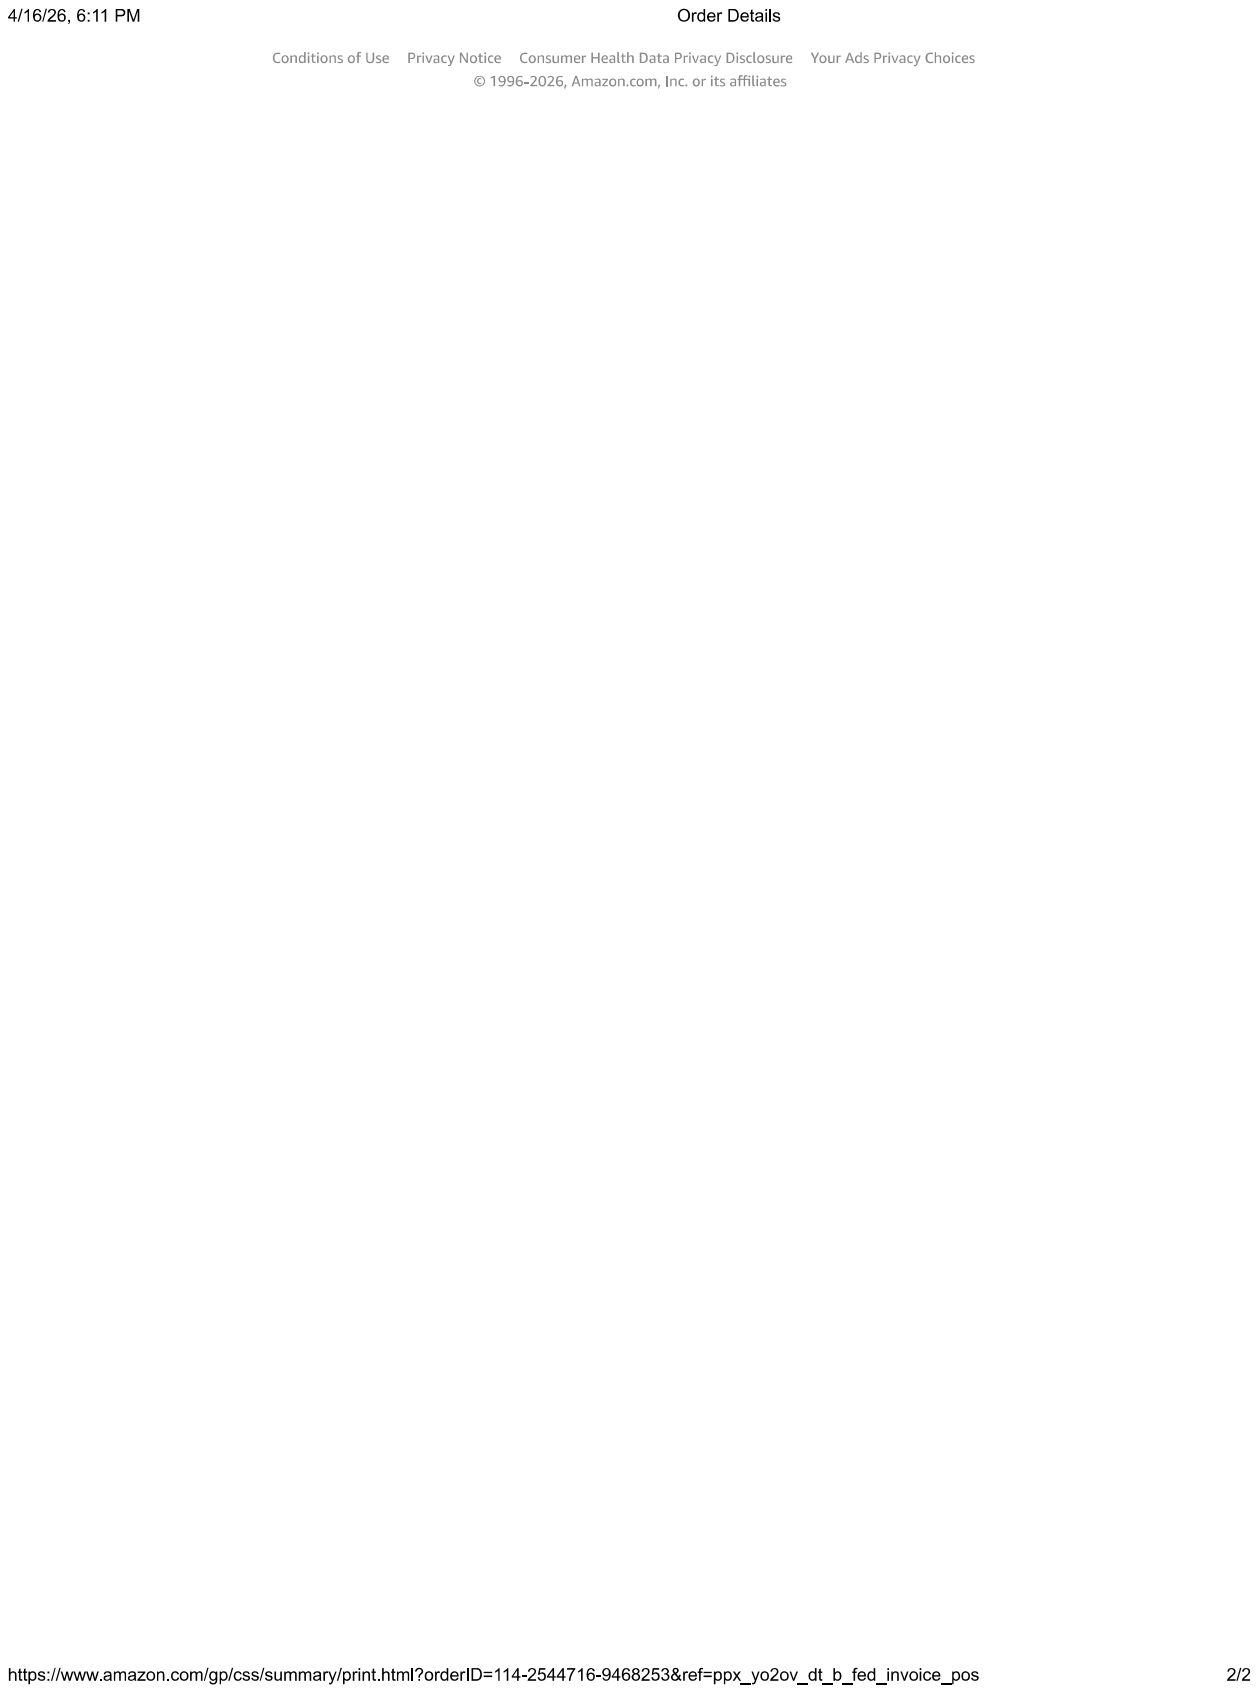
[picture p51: page 2]
