advay03/EME-185---Organ-on-a-chip/Receipts/Invoice Splitter + Heater + Switch + Wago + Clamps - Amazon.pdf

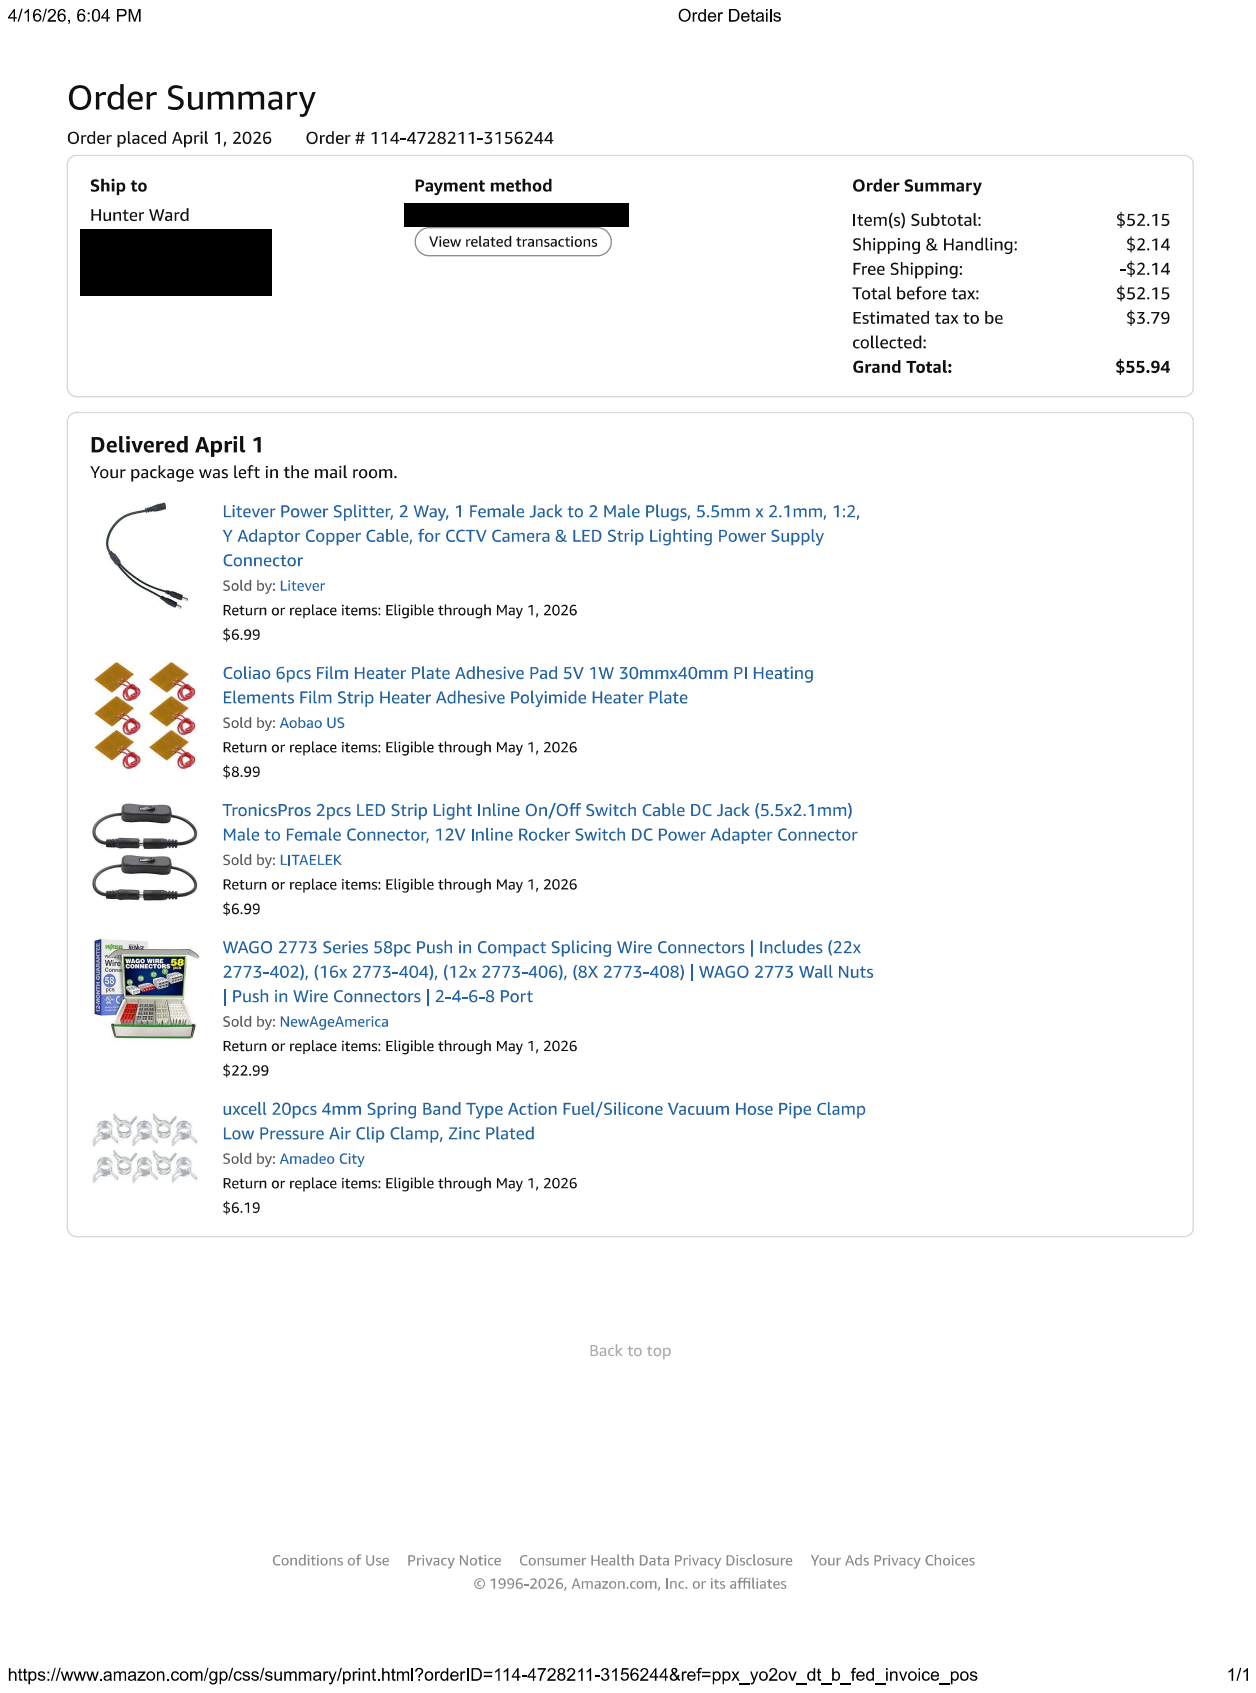
[picture p52: page 1]
