advay03/EME-185---Organ-on-a-chip/Receipts/Invoice Threaded Inserts - Amazon.pdf

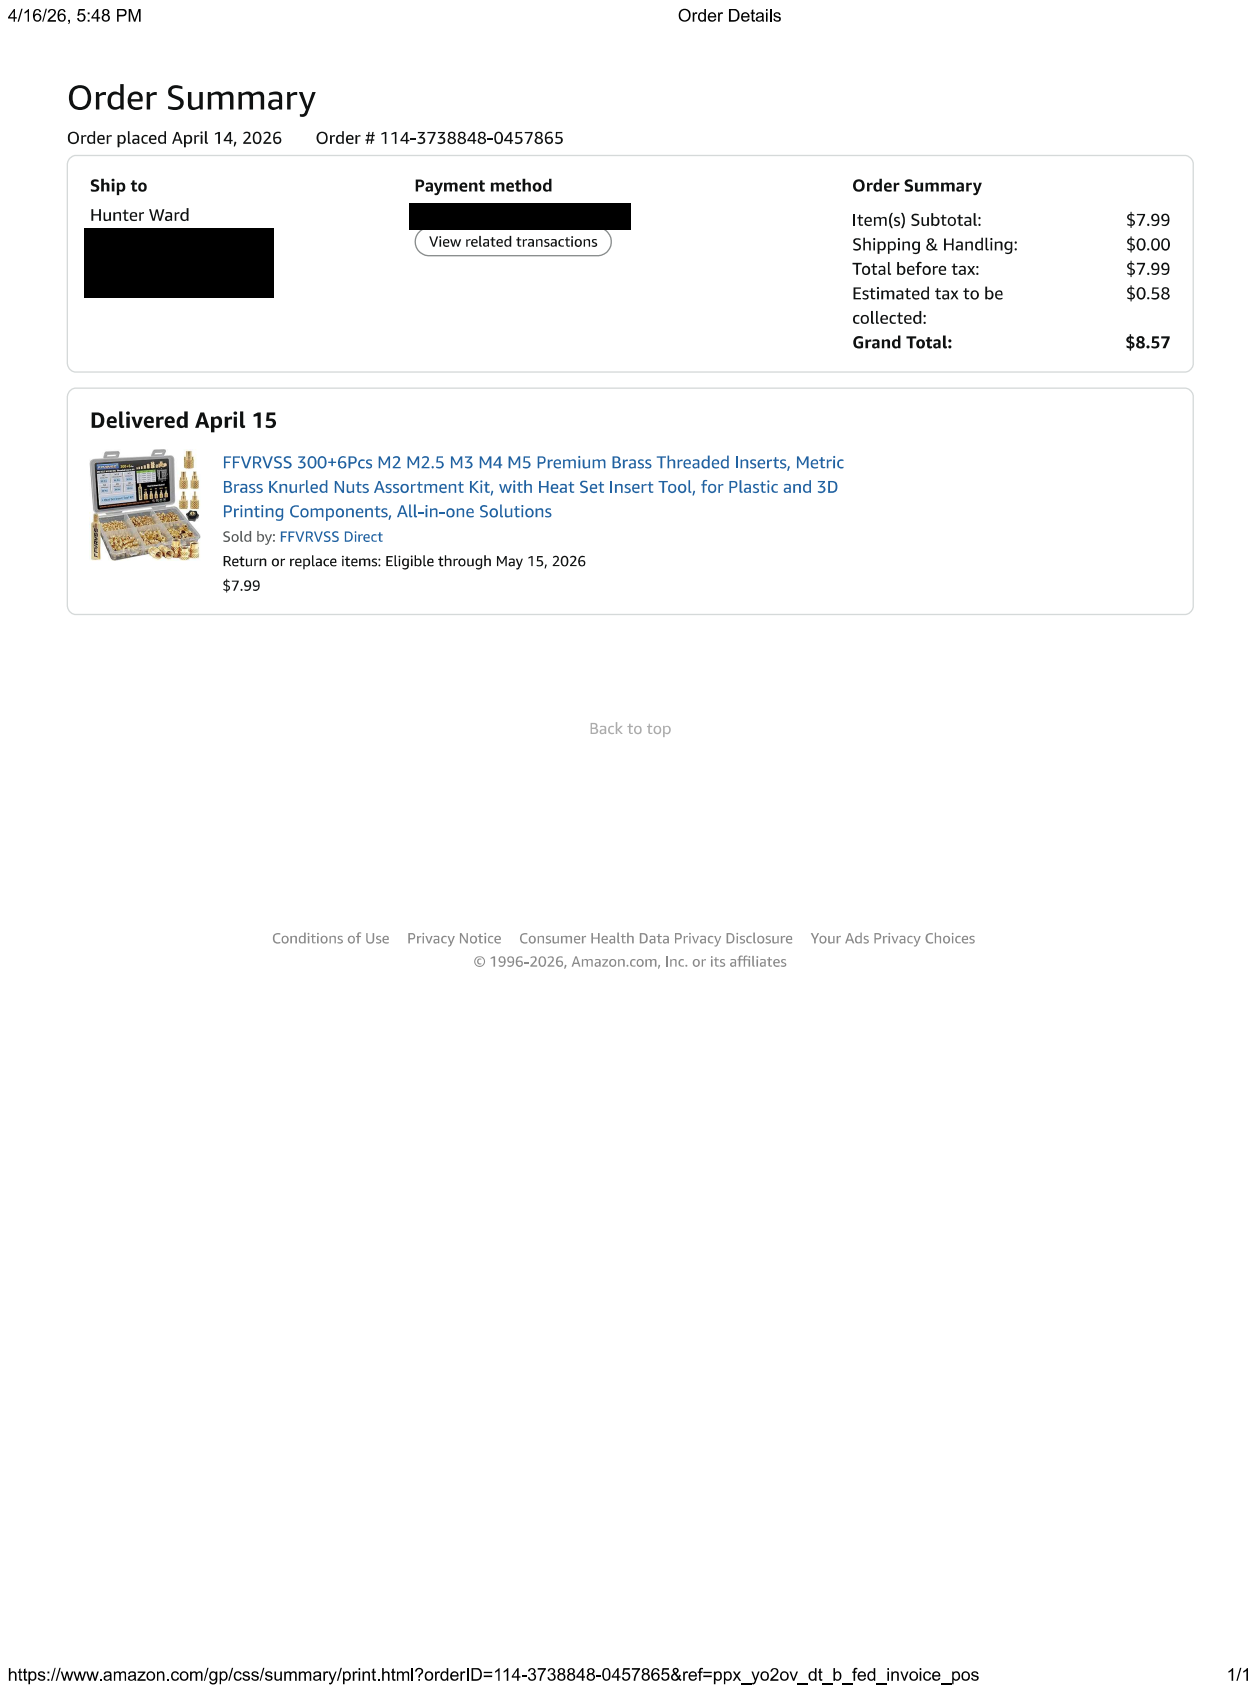
[picture p53: page 1]
