advay03/EME-185---Organ-on-a-chip/Receipts/Invoice USB Hub + Silicone Tubing - Amazon.pdf

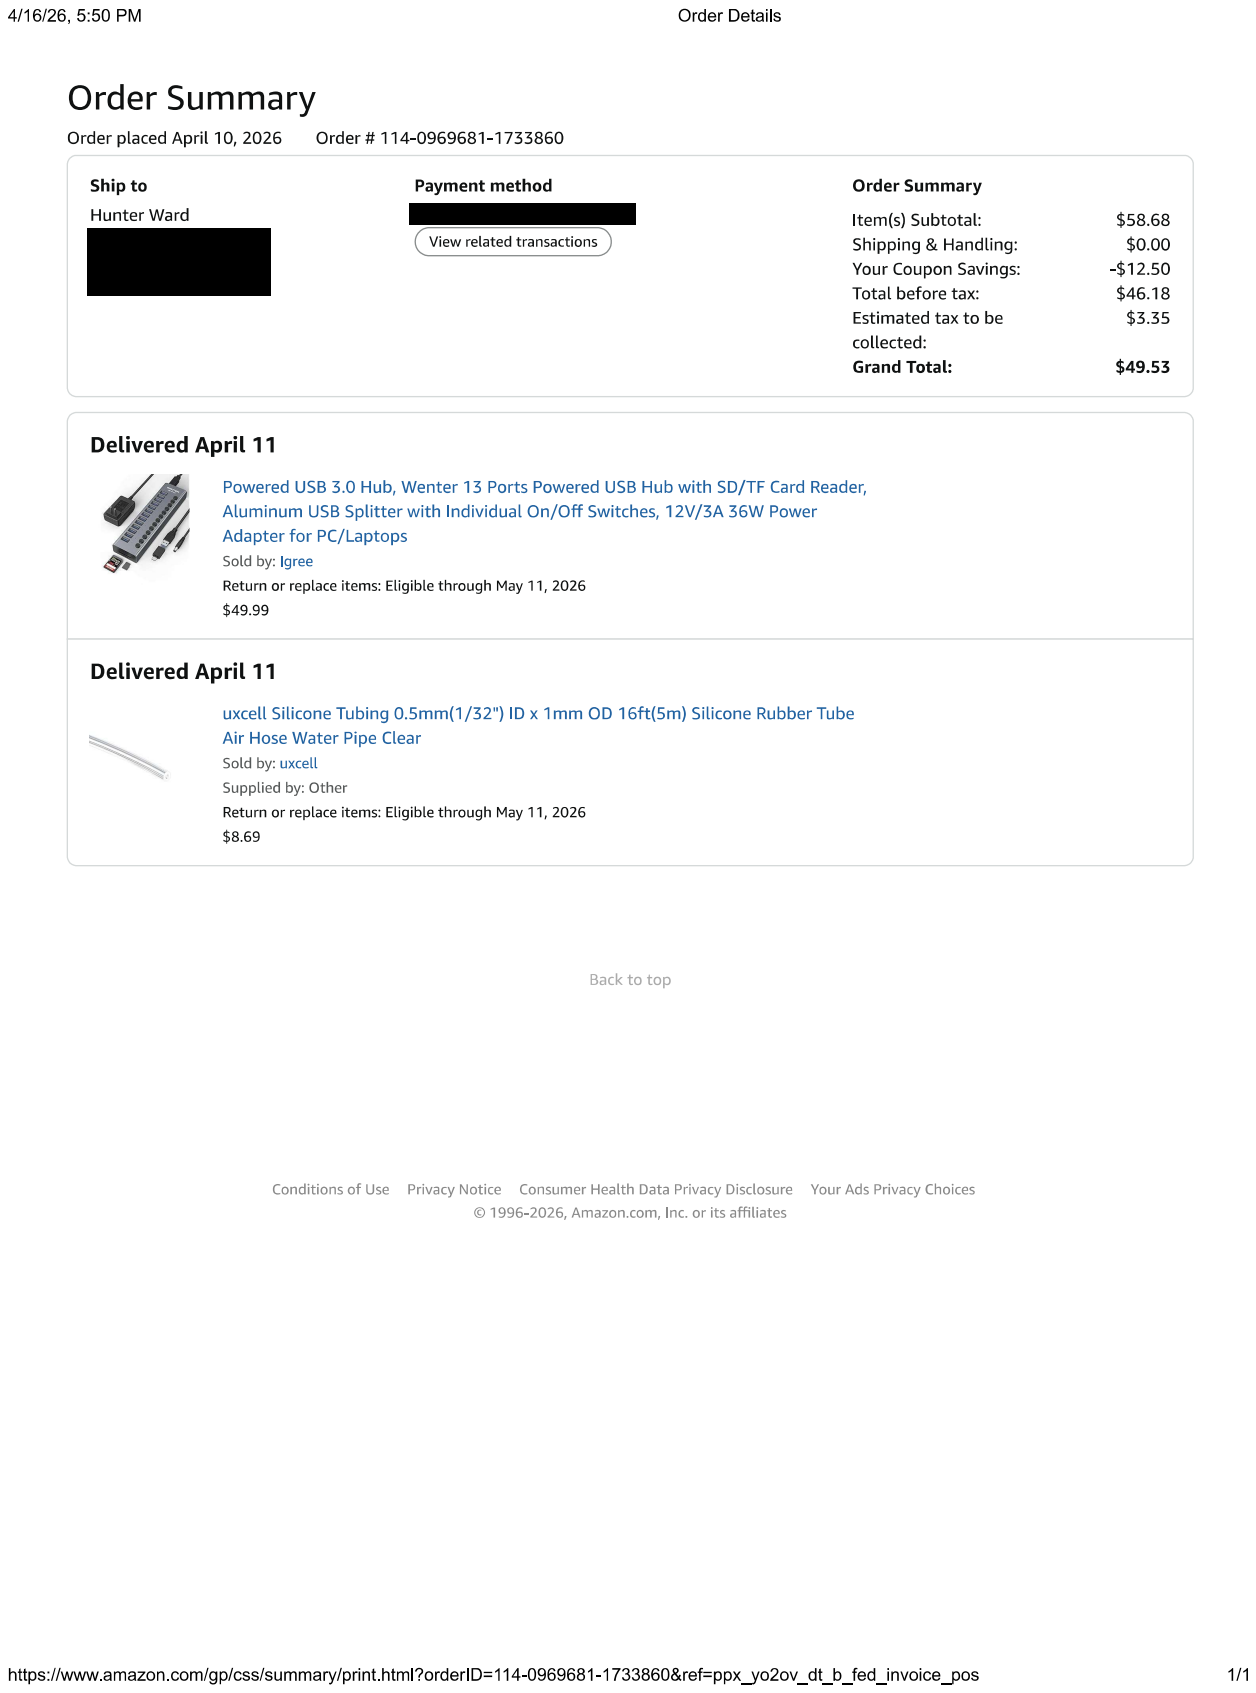
[picture p54: page 1]
