advay03/EME-185---Organ-on-a-chip/Receipts/Invoice Velcro + Heat Tape - Amazon.pdf

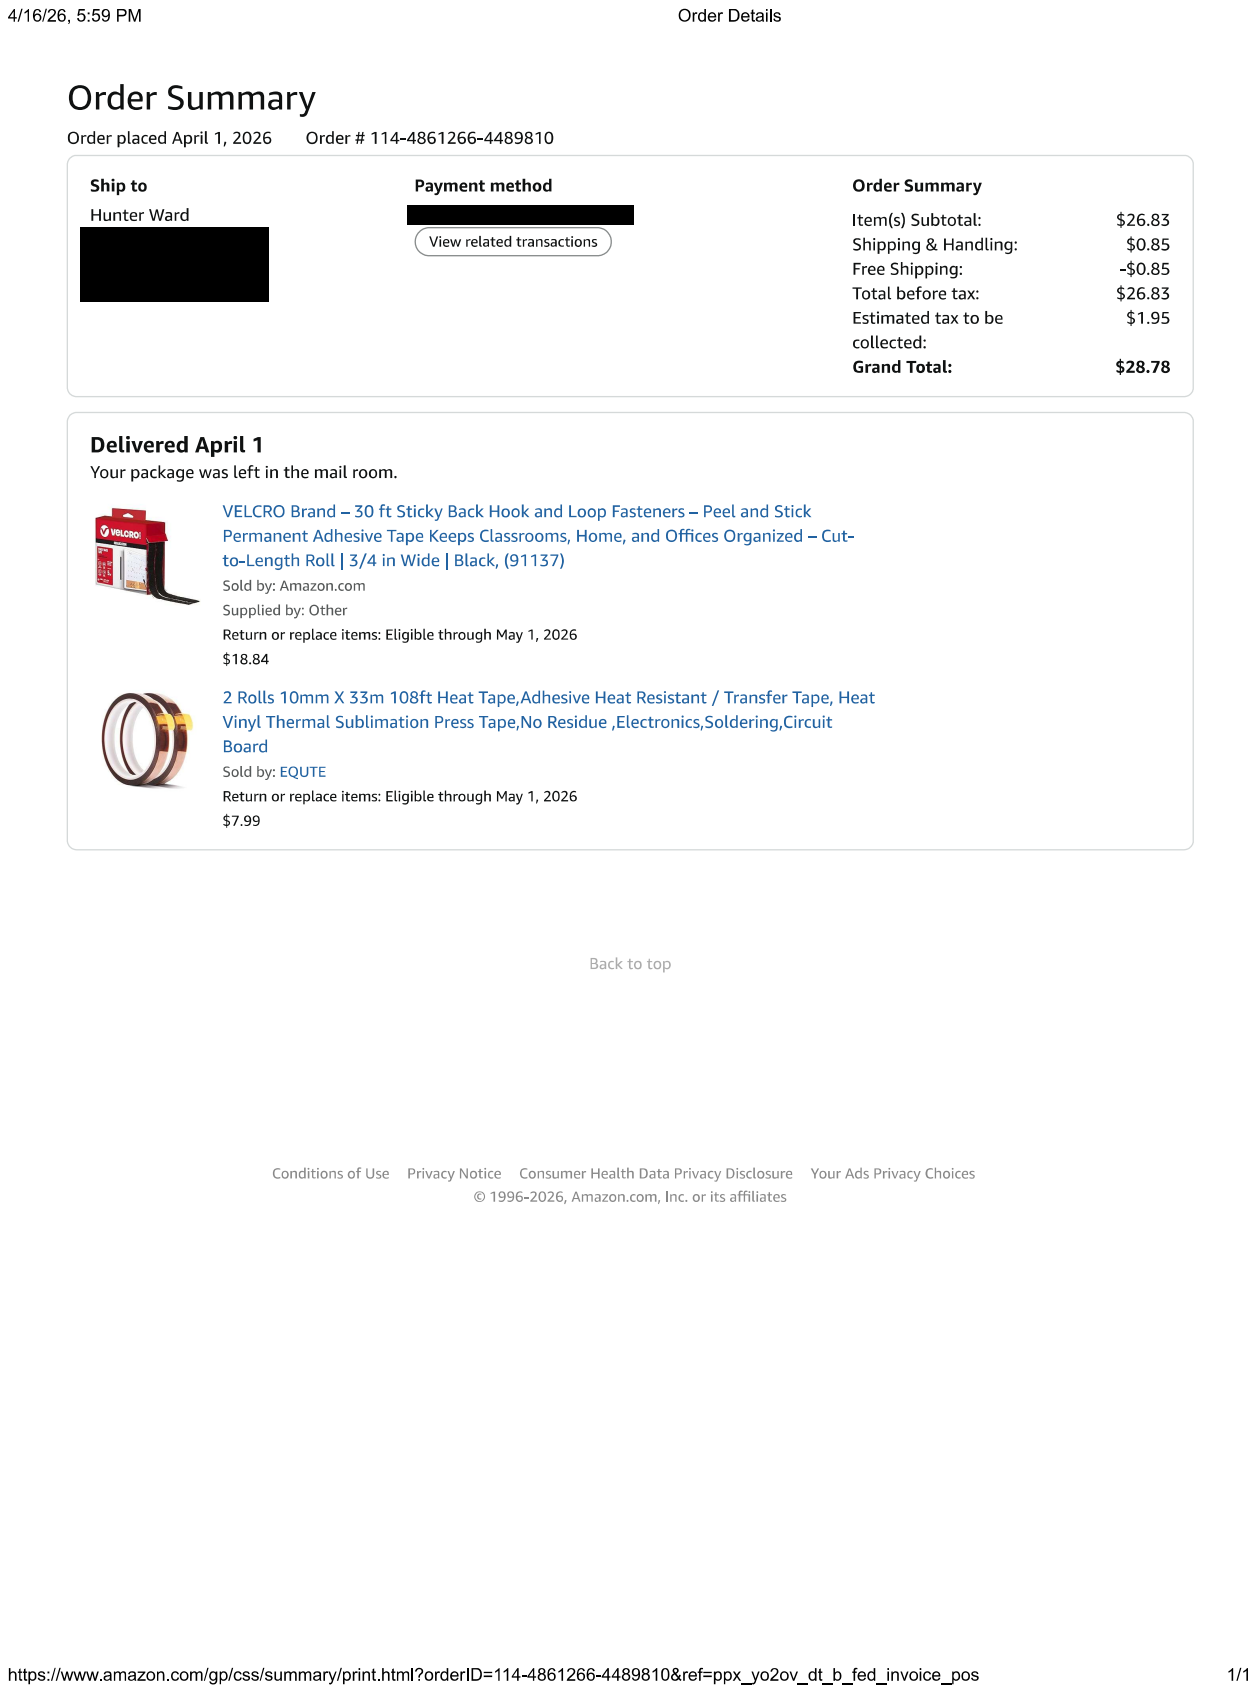
[picture p55: page 1]
