advay03/EME-185---Organ-on-a-chip/Drawings/Rev 2/Pod Base.pdf

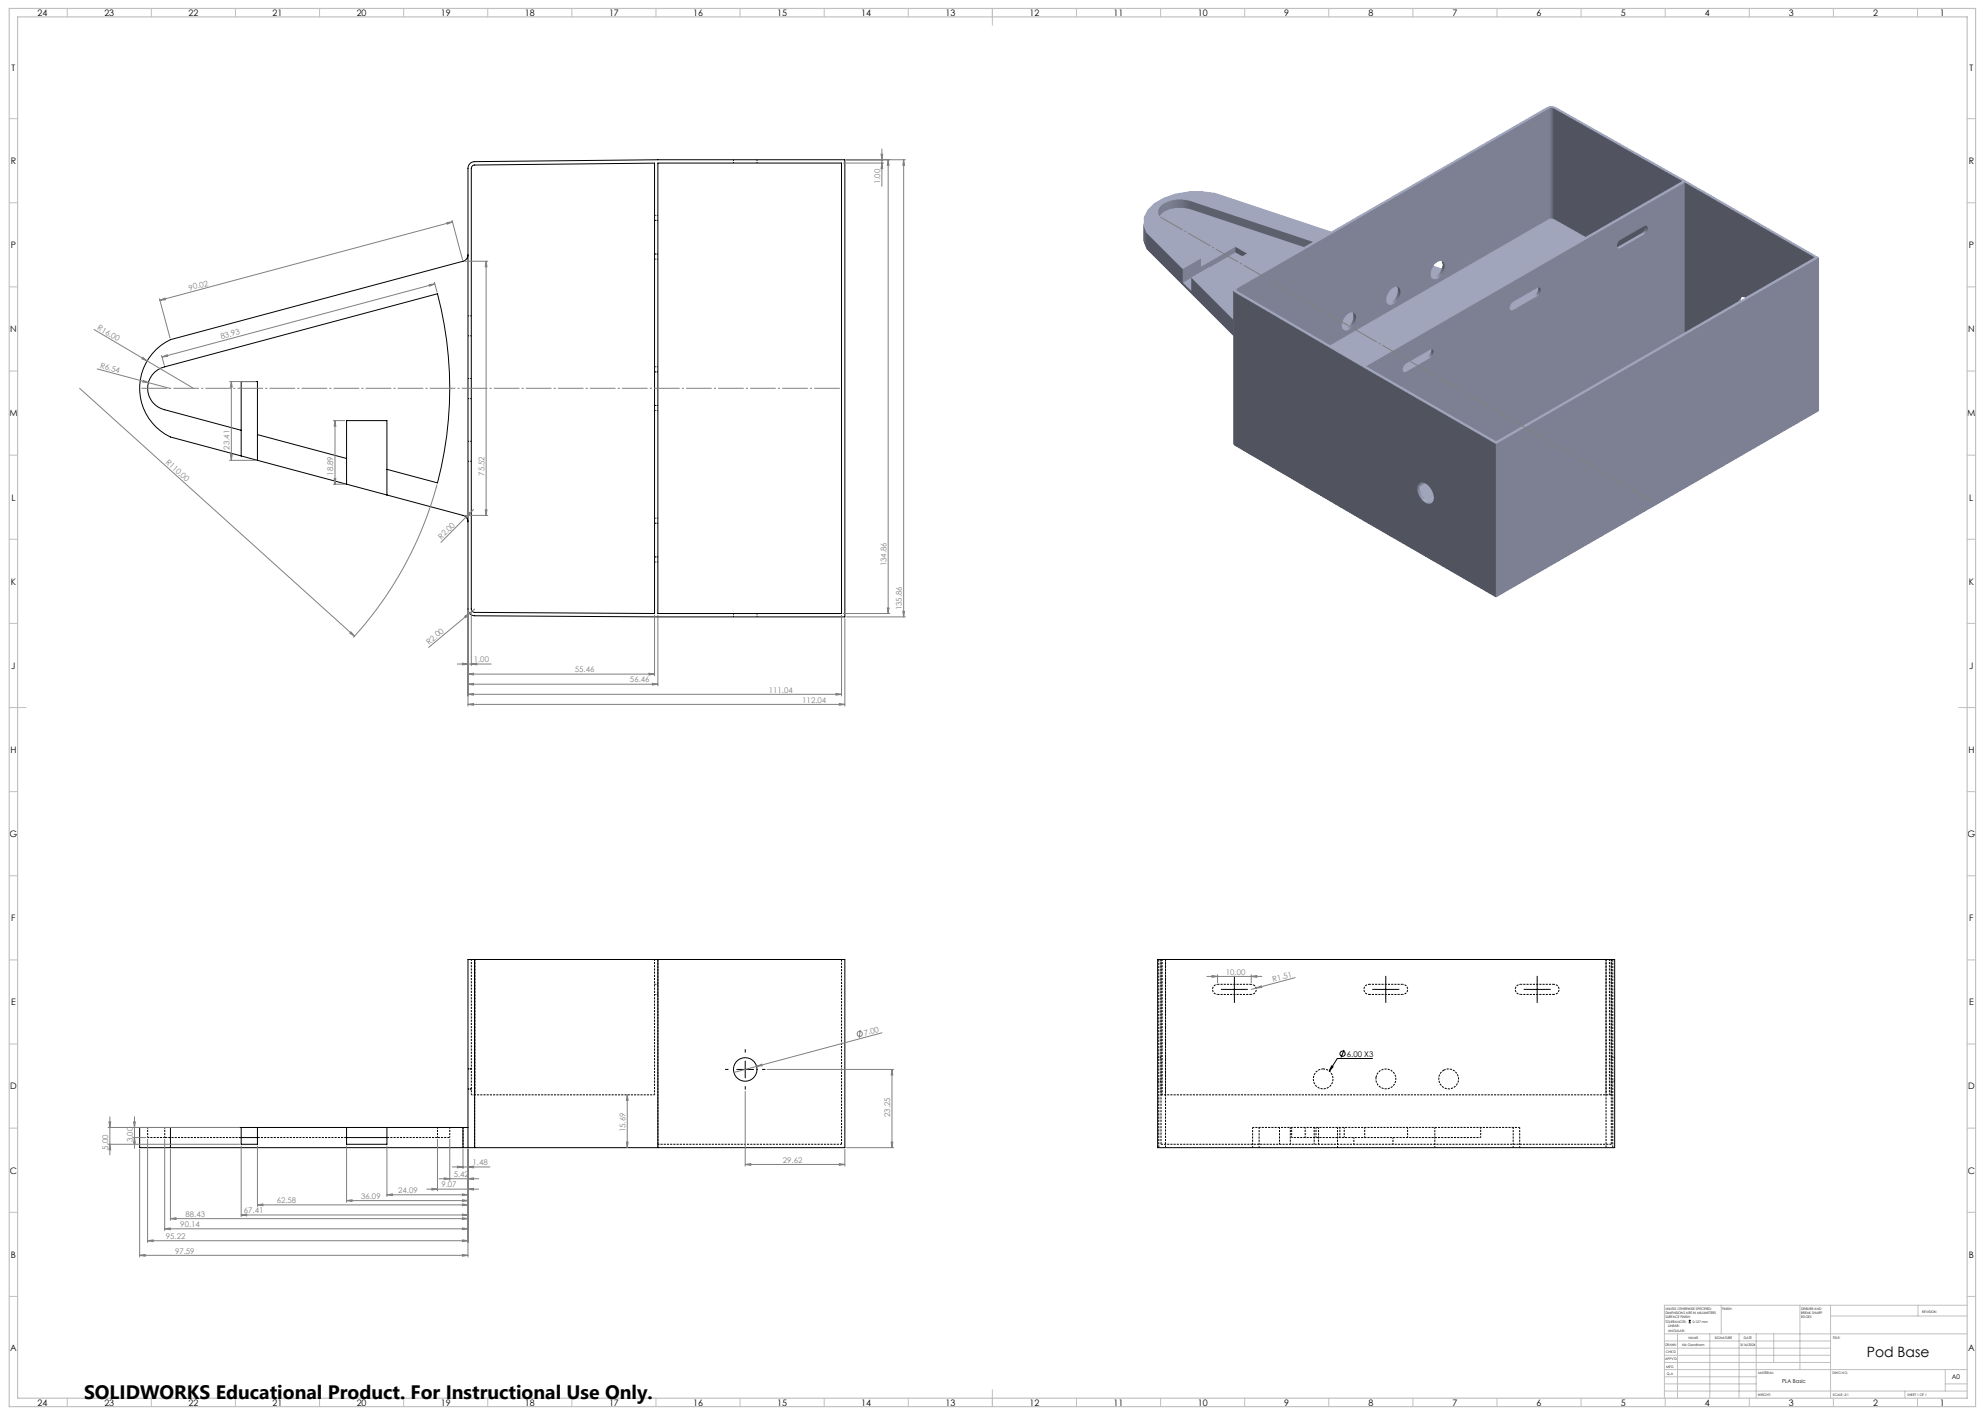
[picture p56: page 1]
TOLERANCES:; FINISH:; DEBURR AND; BREAK SHARP; SCALE: 2:1; SHEET 1 OF 1

UNLESS OTHERWISE SPECIFIED:
DIMENSIONS ARE IN MILLIMETERS
SURFACE FINISH:
LINEAR:
ANGULAR:

NAME | SIGNATURE | DATE | | | | TITLE: Pod Base

SOLIDWORKS Educational Product. For Instructional Use Only.

DRAWN | Nix Gandham | | 3/16/2026
CHK'D
APPV'D
MFG
Q.A | | | | MATERIAL: | DWG NO. | A0 PLA Basic
