advay03/EME-185---Organ-on-a-chip/(commit log)

2026-02-20 First File
    [Peristaltic Pump.stp]
2026-03-11 Create Tray CAD
2026-04-01 Uploading Everything
    [6121 TMC2209 Driver.step, 7487N44_High-Precision Corrosion-Resistant 440C Stainless Steel Ball Bearing.SLDPRT, 8320N61_Barrel-Style DC Connector.SLDPRT, 9915K37_Quick-Connect Push-on Wire Connectors.SLDPRT, Circuit Assembly Lid.SLDDRW, Circuit Assembly Lid.SLDPRT, Electronics System.SLDDRW, HMI.SLDASM]
2026-04-01 01/04/26 Meeting Updates
    Changed the layout and added more components to the assembly
    [6121 TMC2209 Driver.SLDASM, Arduino Holder.SLDPRT, MC Board Base.SLDPRT, MC Board Spacer.SLDPRT, System Assembly.SLDASM]
2026-04-03 Rev 2 Update
    Added the rest of the components and finished the Rev 2 Assembly
    [6121 TMC2209 Driver.SLDASM, 9915K36_Quick-Connect Push-on Wire Connectors.SLDPRT, Perf Board Holder.SLDPRT, Pod Base_Rev2.SLDPRT, Pump Riser.SLDPRT, System Assembly.SLDASM, Tray Base_Rev2.SLDPRT]
2026-04-03 pump files
    [CheapPump.SLDPRT, CheapPump3-1mm-CheapPump.STL, CheapPump3-1mm-pump-top.STL, Pod for team 14.CATPart, Pod for team 14.stl, PumpaCheapo.SLDASM, bearing-hub-top.SLDPRT, bearing-hub-top.stl]
2026-04-04 Tray Dimensions Drawing
    [Pump Subassembly.SLDASM, System Assembly.SLDASM, Tray Dimensions Drawing.SLDDRW]
2026-04-07 Create Custom design.SLDPRT
    [Custom design.SLDPRT]
2026-04-08 Custom Pump Design Preliminary
    [Custom design.SLDPRT]
2026-04-14 Pump Changes
    [57155K341_Stainless Steel Ball Bearing.SLDPRT, 91305A103_JIS Zinc-Plated Steel Flat Head Screws.SLDPRT, 91430A150_18-8 Stainless Steel Slotted Flat Head Screw.SLDPRT, Custom Pump Assembly.SLDASM, Custom_design_iter_1.SLDPRT, Dowel Pins.SLDPRT]
2026-04-17 Tray V3
    [Custom Pump Assembly.SLDASM, Custom_Housing.STL, Custom_Housing_Cap.STL, Custom_Rotor.STL, Custom_Rotor_Cap.STL, Custom_design_iter_1.SLDPRT, Part1.SLDPRT, Pod for team 14.SLDPRT]
2026-04-20 Rev 3 Final
    [6121 TMC2209 Driver.SLDASM, 91292A113_18-8 Stainless Steel Socket Head Screw.SLDPRT, Arduino Holder.SLDPRT, Custom Pump Assembly.SLDASM, Perf Board Holder.SLDPRT, Peristaltic Pump Holder_Rev-3.SLDPRT, Pod for team 14.SLDPRT, System Assembly - Rev 3.SLDASM]
2026-04-20 Rev 3 Printing updates
    [Arduino Holder.STL, Perf Board Holder.STL, Peristaltic Pump Holder_Rev-3.STL, System Assembly - Rev 3.SLDASM, Tray_Rev3.SLDPRT, Tray_Rev3.STL]
2026-04-21 Rev 3 Change
    [System Assembly - Rev 3.SLDASM]
2026-04-30 pump design changves
    [Custom_design_iter_1.SLDPRT, Custom_design_v2.SLDPRT]
2026-05-06 pump v3
    [Custom_design_v2.SLDPRT, Custom_design_v3.SLDPRT]
2026-05-07 pump fix
    [Custom_design_v3.SLDPRT]
2026-05-16 rms current
2026-05-21 tolerance changes
    [Custom_design_v2.SLDPRT]
2026-05-25 Assembly Update
    [Bearing Jig Lower.STL, Bearing Jig Upper.STL, Custom Pump Assembly.SLDASM, Custom_Housing.STL, Custom_Housing_Cap.STL, Custom_Rotor.STL, Custom_Rotor_Cap.STL, Custom_design_v2.SLDPRT]
2026-06-06 Update
    Added all the drawings to the drawings folder + Folder restructuring. Also made the final changes to the assembly and added all the exploded views.
    [6121 TMC2209 Driver.SLDASM, 91292A113_18-8 Stainless Steel Socket Head Screw.SLDPRT, Arduino 1_temperature_log_20260605_114339.csv, Arduino Holder.SLDDRW, Bearing Jig Lower.SLDPRT, Bearing Jig.SLDDRW, Bearing Jig.SLDPRT, Circuit Assembly Lid.SLDDRW]
